Ulf-vom-Mond/heichips26-voltage-controlled-resistor/macros/heichips26_vcr/macros/switched_capacitor/testbenches/xschem/plot_simulations/figures/linearity_vcm_step=0.1_vdm=0.5.pdf

relative deviation from mean resistance in %

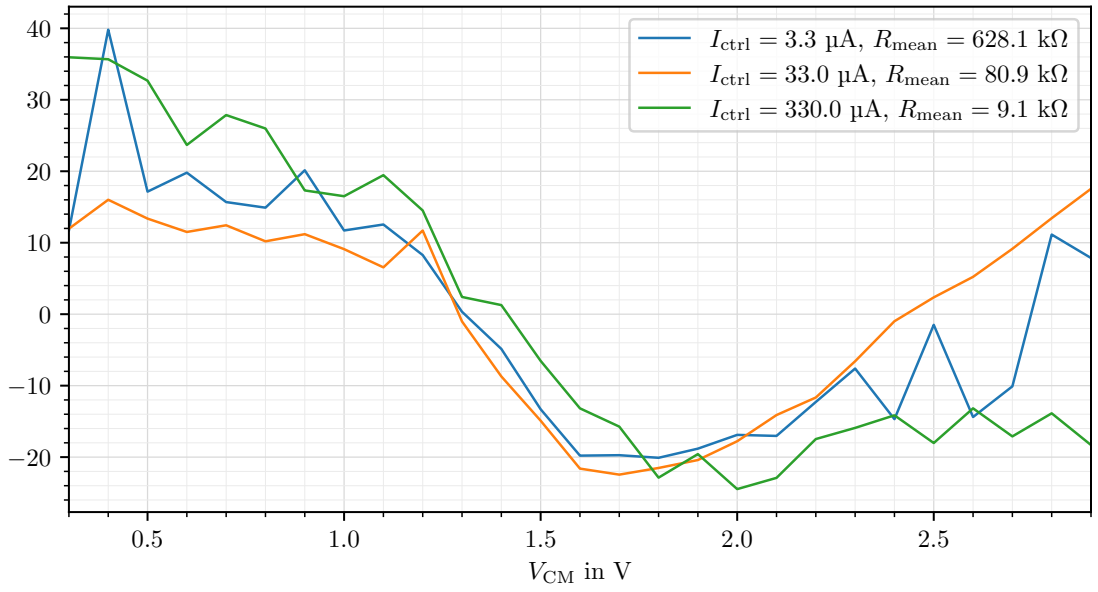
[picture p2: figure]
VCM in V; Ictrl = 3.3; µA, Rmean = 628.1 kΩ; Ictrl = 330.0 µA,; Rmean

Ictrl = 33.0 µA, Rmean = 80.9 kΩ

### Linearity with respect to VCM for VDM = 0.5 V
