Ulf-vom-Mond/heichips26-voltage-controlled-resistor/macros/heichips26_vcr/macros/switched_capacitor/testbenches/xschem/plot_simulations/figures/linearity_ictrl_step=1.1.pdf

### Linearity with respect to Ictrl

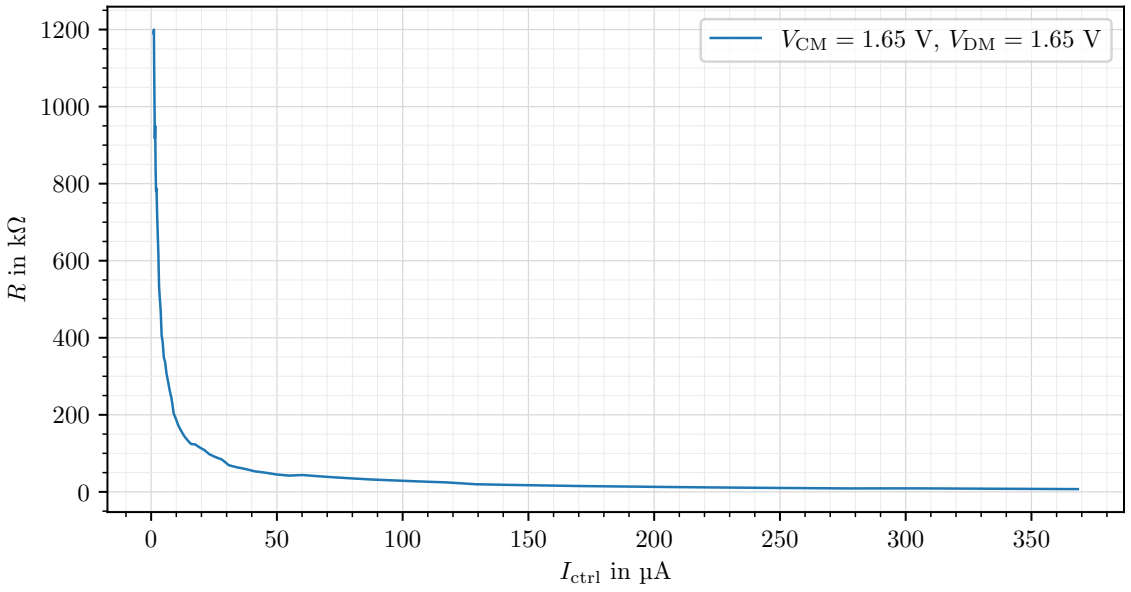
[picture p3: figure]
Ictrl in µA; VCM; V, VDM
