Ulf-vom-Mond/heichips26-voltage-controlled-resistor/macros/heichips26_vcr/macros/switched_capacitor/testbenches/xschem/plot_simulations/figures/linearity_ictrl-1_step=1.1.png

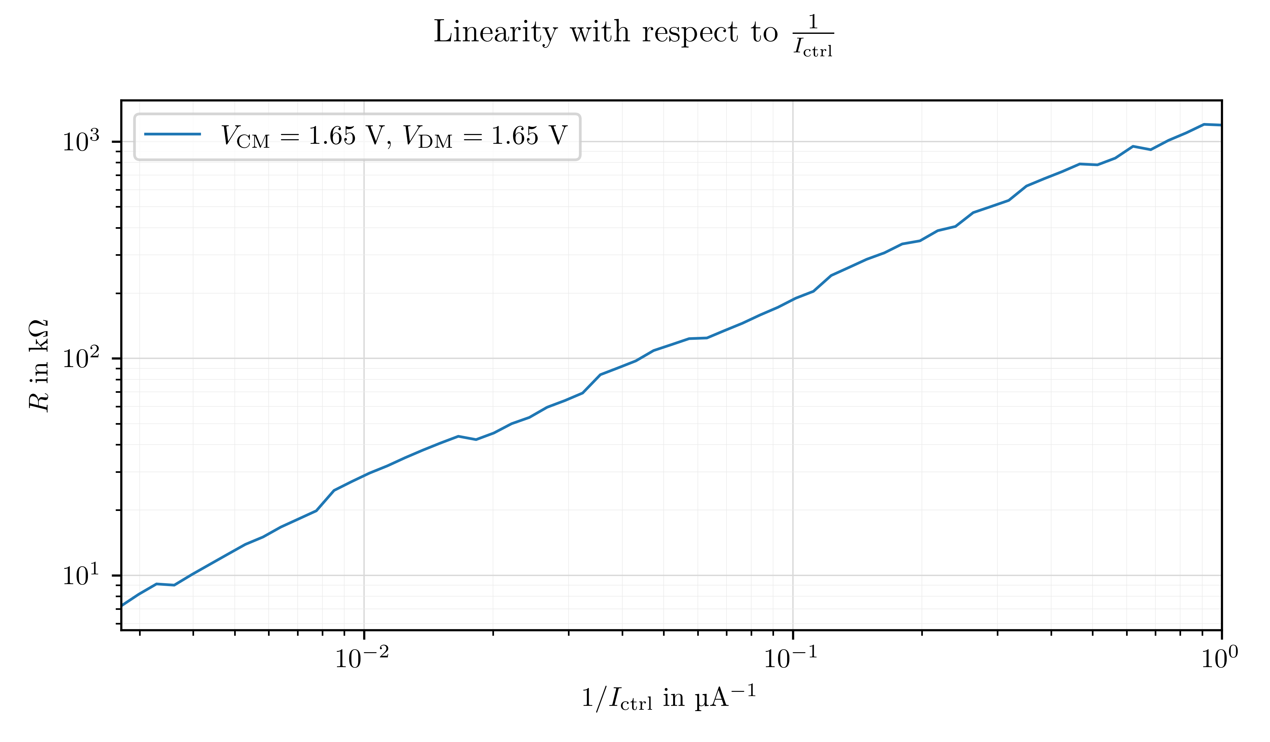
macros/heichips26_vcr/macros/switched_capacitor/testbenches/xschem/plot_simulations/figures/linearity_ictrl-1_step=1.1.png
