Ulf-vom-Mond/heichips26-voltage-controlled-resistor/macros/heichips26_vcr/macros/switched_capacitor/testbenches/xschem/plot_simulations/figures/linearity_ictrl-1.pdf

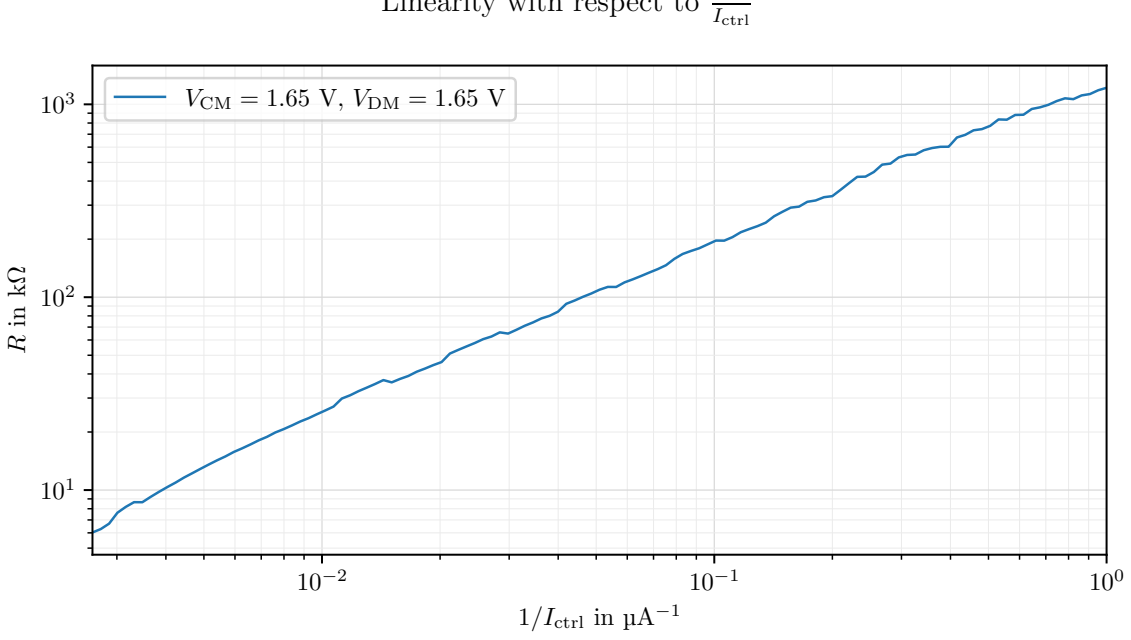
[picture p7: figure]
1/Ictrl in µA−1; VCM; V, VDM = 1.65 V; Ictrl

### Linearity with respect to 1
