Ulf-vom-Mond/heichips26-voltage-controlled-resistor/macros/heichips26_vcr/macros/switched_capacitor/testbenches/xschem/plot_simulations/figures/linearity_vco_vdm_detailed.pdf

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
VDM in V

−40 −200

20

40

relative deviation from median resistance in %
Ictrl | = 0 | .1 | V, | Rmedian | = 11 | .0 kΩ
Ictrl | = 0 | .5 | V, | Rmedian | = 102 | .6 | kΩ
Ictrl | = 3 | .3 | V, | Rmedian | = 1193 | .8 kΩ

### Linearity with respect to

### VDM for

### VCM = 1.65 V
