Ulf-vom-Mond/heichips26-voltage-controlled-resistor/macros/heichips26_vcr/macros/switched_capacitor/testbenches/xschem/plot_simulations/figures/linearity_vdm_detailed.pdf

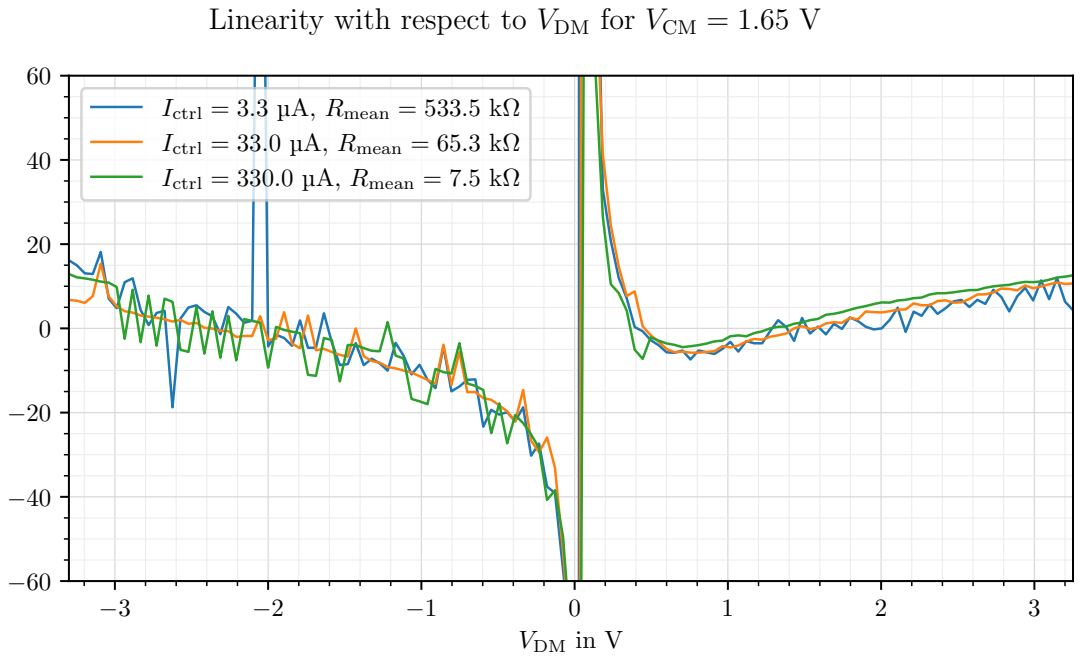
[picture p8: figure]
VDM in V; Ictrl; Rmean; Rmean = 65; Linearity with respect to; VDM for; VCM = 1.65 V

relative deviation from median resistance in %
