Ulf-vom-Mond/heichips26-voltage-controlled-resistor/macros/heichips26_vcr/macros/switched_capacitor/testbenches/xschem/plot_simulations/figures/linearity_vdm_start=0.pdf

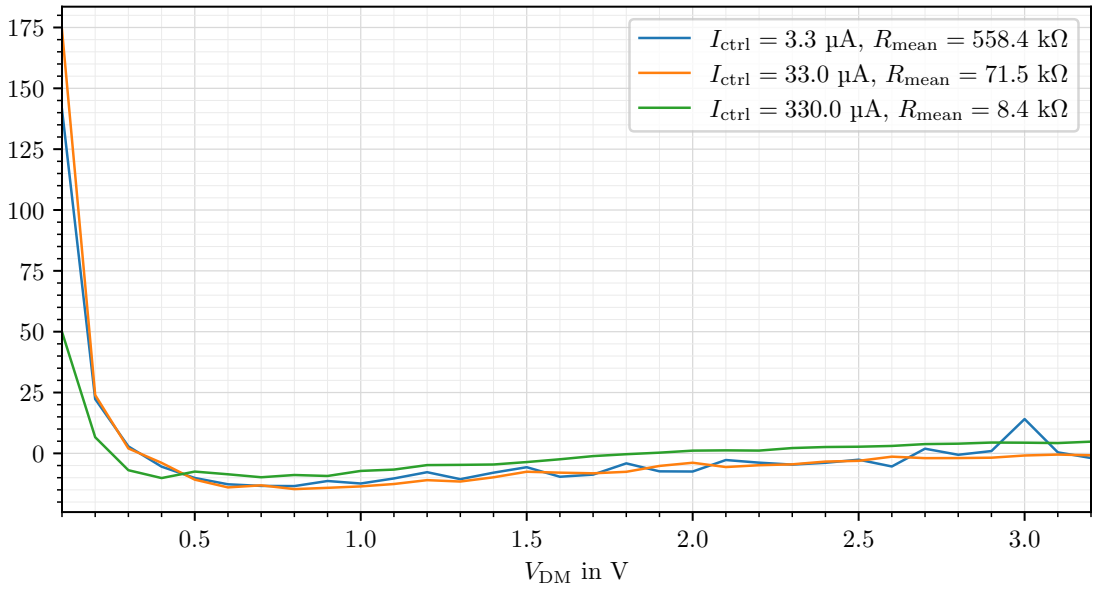
[picture p10: figure]
VDM in V; Ictrl; µA, Rmean = 558.4 kΩ; = 33.0 µA, Rmean; Rmean = 8.4 kΩ

relative deviation from mean resistance in %

### Linearity with respect to VDM for VCM = 1.65 V
