Ulf-vom-Mond/heichips26-voltage-controlled-resistor/macros/heichips26_vcr/macros/switched_capacitor/testbenches/xschem/plot_simulations/figures/inverter_tb_ac_ol.pdf

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

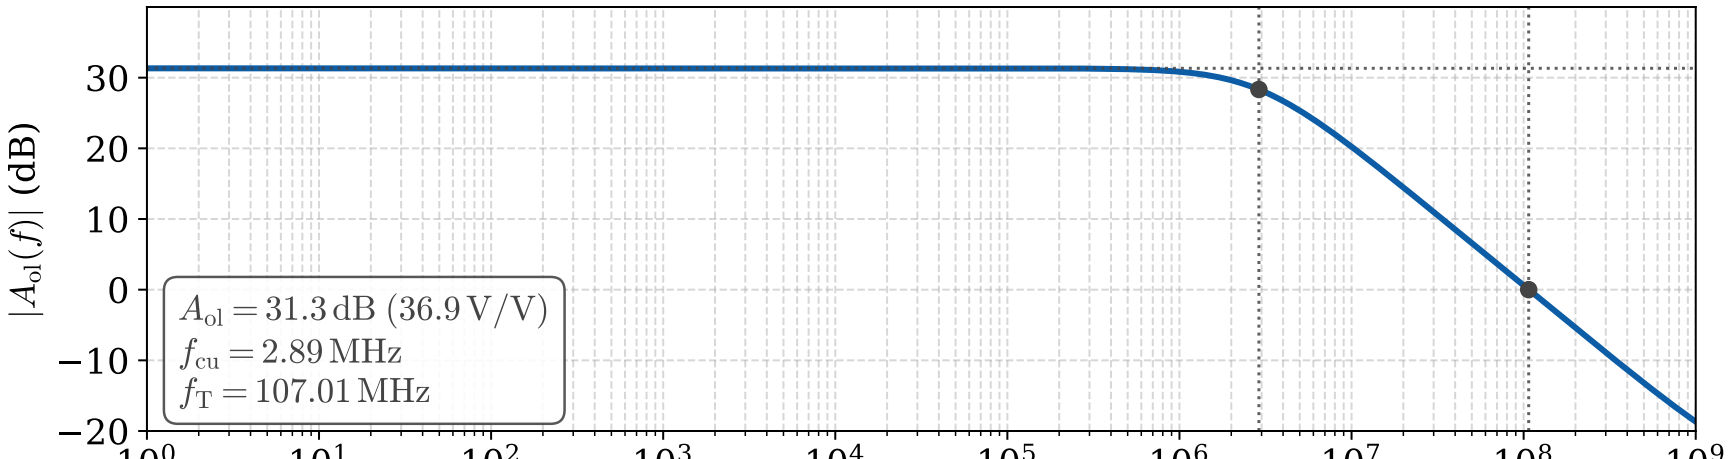
[picture p11: figure]
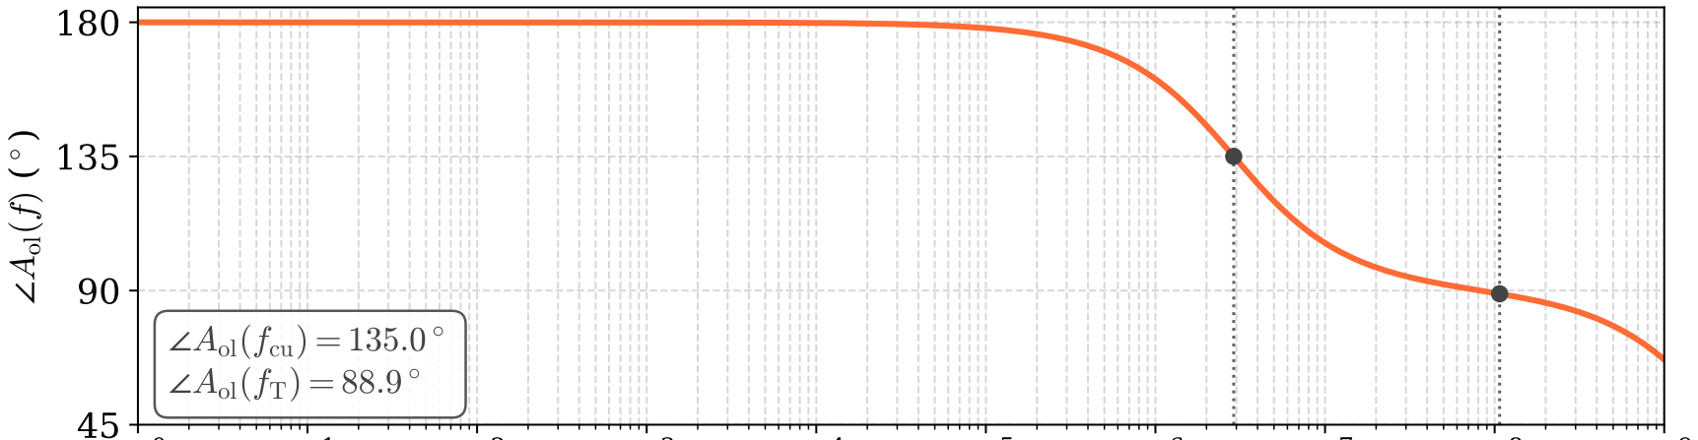
[picture p12: figure]
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
