Ulf-vom-Mond/heichips26-voltage-controlled-resistor/macros/heichips26_vcr/macros/switched_capacitor/testbenches/xschem/plot_simulations/figures/linearity_ictrl.pdf

### Linearity with respect to Ictrl

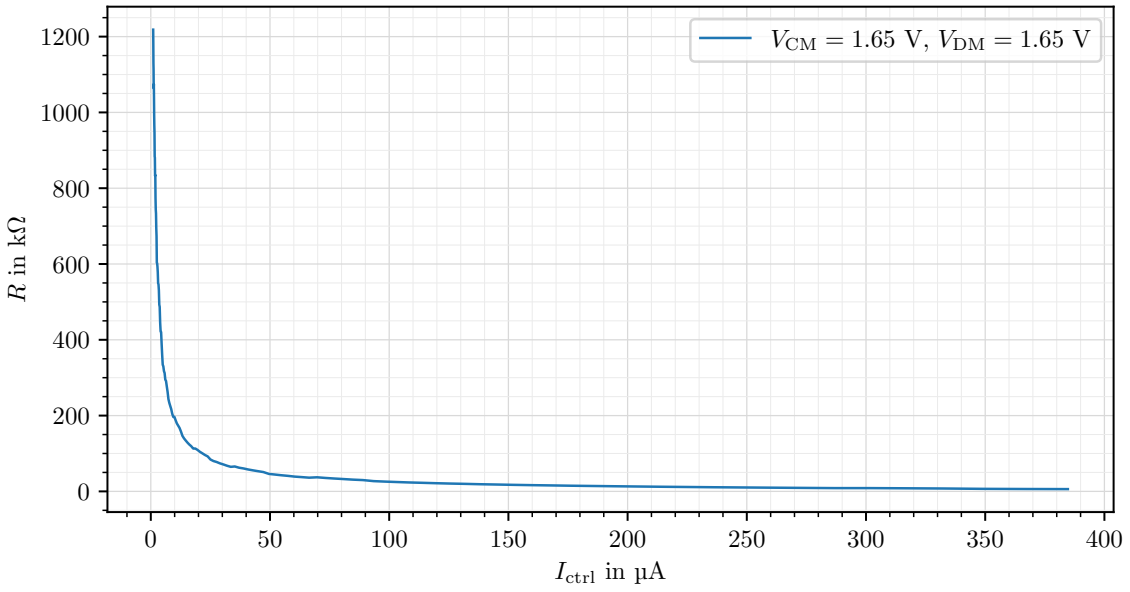
[picture p13: figure]
Ictrl in µA; VCM; VDM
