Ulf-vom-Mond/heichips26-voltage-controlled-resistor/macros/heichips26_vcr/testbenches/xschem/plot_simulations/figures/heichips26_analog_project_tb_tran.csv

time_ms | uio_in_0 | analog_0 | analog_1 | analog_2
0.000000000000000000e+00 | 0.000000000000000000e+00 | 7.500000000000000000e-01 | 5.371804900000000105e-01 | 1.499998240000000038e+00
1.000000000000000087e-07 | 1.499999999999999944e-02 | 7.500000060000000524e-01 | 5.371804900000000105e-01 | 1.500930510000000107e+00
2.000000000000000174e-07 | 2.999999999999999889e-02 | 7.500000129999999654e-01 | 5.371804890000000388e-01 | 1.501783129999999966e+00
4.000000000000000348e-07 | 5.999999999999999778e-02 | 7.500000249999999591e-01 | 5.371804869999999843e-01 | 1.503318050000000072e+00
8.000000000000000697e-07 | 1.199999999999999956e-01 | 7.500000500000000292e-01 | 5.371804780000000168e-01 | 1.505754159999999953e+00
1.600000000000000139e-06 | 2.399999999999999911e-01 | 7.500001010000000301e-01 | 5.371804399999999813e-01 | 1.508771639999999969e+00
2.157522970000000198e-06 | 3.236284449999999868e-01 | 7.500001360000000394e-01 | 5.371803979999999479e-01 | 1.509247840000000007e+00
2.785727209999999671e-06 | 4.178590810000000211e-01 | 7.500001750000000467e-01 | 5.371803360000000360e-01 | 1.507161699999999938e+00
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
