Ulf-vom-Mond/heichips26-voltage-controlled-resistor/macros/heichips26_vcr/macros/switched_capacitor/verification/cace/scripts/inverter_tb_ac.csv

Adc_ol_dB_arr | fcu_arr
2.405539999999999878e+01 | 6.704690000000000000e+06
1.506770000000000032e+01 | 1.600880000000000000e+07
2.489160000000000039e+01 | 6.194410000000000000e+06
2.377299999999999969e+01 | 6.722840000000000000e+06
2.597490000000000165e+01 | 5.180040000000000000e+06
1.481630000000000003e+01 | 1.659160000000000000e+07
1.343140000000000001e+01 | 1.809050000000000000e+07
1.512870000000000026e+01 | 1.499380000000000000e+07
9.545130000000000337e+00 | 2.905970000000000000e+07
3.096499999999999986e+01 | 2.854580000000000000e+06
9.753949999999999676e+00 | 2.789630000000000000e+07
2.980600000000000094e+01 | 3.415400000000000000e+06
1.348509999999999920e+01 | 2.118120000000000000e+07
3.199399999999999977e+01 | 2.592250000000000000e+06
2.780999999999999872e+01 | 4.148880000000000000e+06
3.094460000000000122e+01 | 3.008110000000000000e+06
3.020319999999999894e+01 | 3.234940000000000000e+06
1.413889999999999958e+01 | 1.820030000000000000e+07
8.673180000000000334e+00 | 2.784930000000000000e+07
1.210999999999999943e+01 | 2.263300000000000000e+07
7.307129999999999903e+00 | 3.552400000000000000e+07
2.046969999999999956e+01 | 9.596920000000000000e+06
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
