Ulf-vom-Mond/heichips26-voltage-controlled-resistor/macros/heichips26_vcr/macros/switched_capacitor/testbenches/xschem/plot_simulations/figures/linearity_vcm.pdf

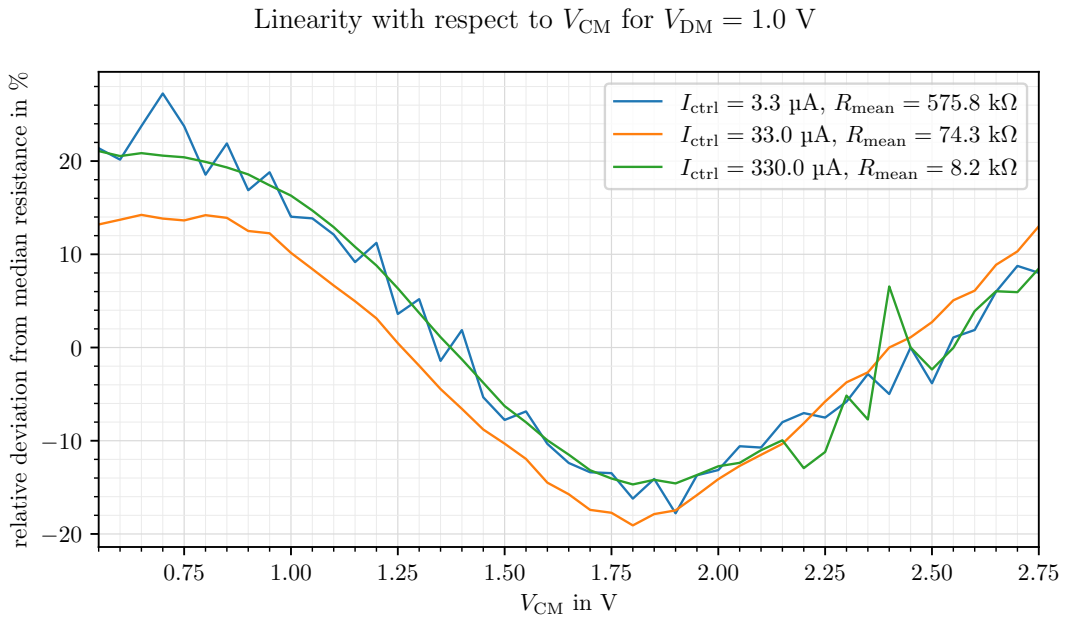
[picture p23: page 1]
VCM in V; Ictrl; Rmean = 8.2 kΩ

Linearity with respect to VCM for VDM = 1.0 V

relative deviation from median resistance in %

Ictrl | = 3.3 | µA, | Rmean = 575.8 kΩ
Ictrl | = 33.0 µA, | | | Rmean | = 74.3 kΩ
