Ulf-vom-Mond/heichips26-voltage-controlled-resistor/macros/heichips26_vcr/macros/switched_capacitor/testbenches/xschem/plot_simulations/figures/linearity_vco_vcm.pdf

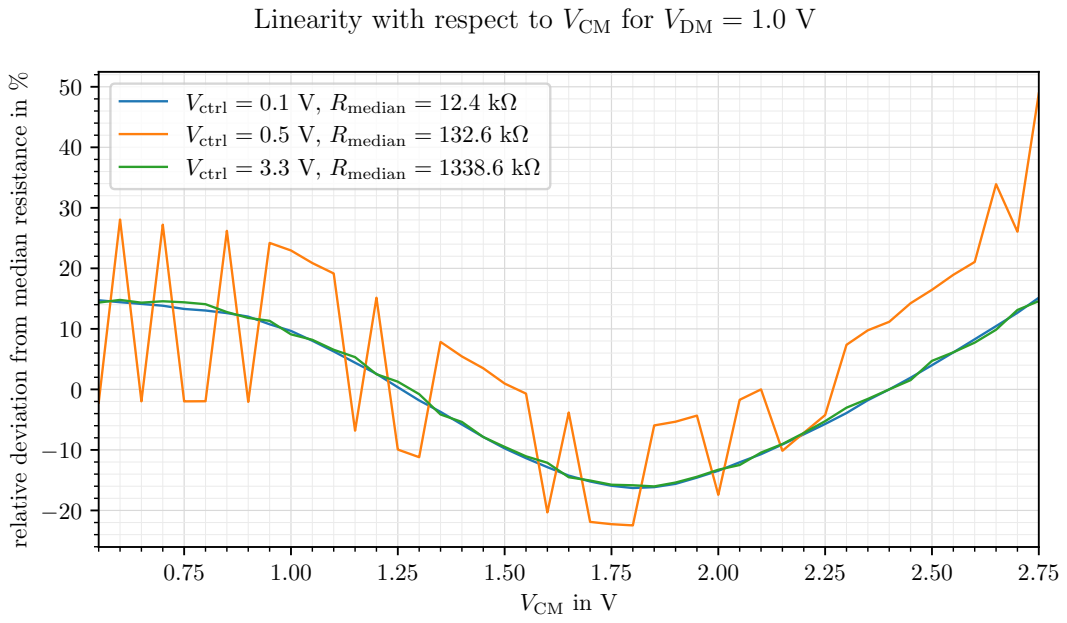
[picture p24: page 1]
VCM in V; Vctrl; Rmedian = 12; Rmedian = 132; Rmedian = 1338; VCM for; VDM = 1.0 V

Linearity with respect to

relative deviation from median resistance in %
