Ulf-vom-Mond/heichips26-voltage-controlled-resistor/macros/heichips26_vcr/macros/switched_capacitor/testbenches/xschem/plot_simulations/figures/linearity_vco_vdm.pdf

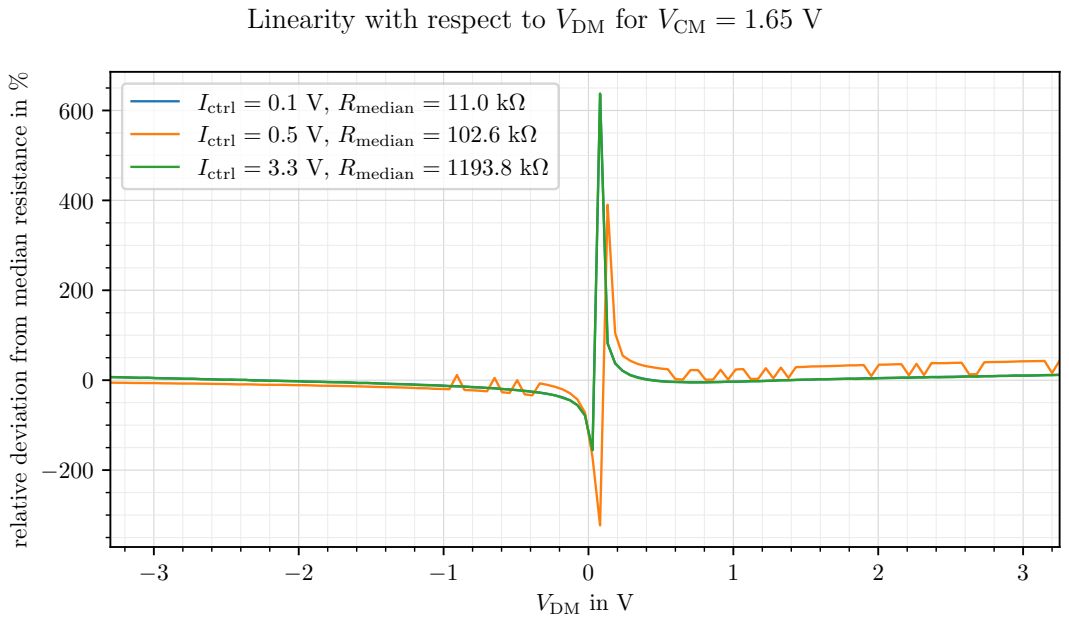
[picture p25: page 1]
VDM in V; Ictrl; Rmedian; VDM for; VCM = 1.65 V

Linearity with respect to

relative deviation from median resistance in %

Ictrl | = 0 | .5 | V, | Rmedian | = 102 | .6 | kΩ

Ictrl | = 3 | .3 | V, | Rmedian | = 1193 | .8 kΩ
