Ulf-vom-Mond/heichips26-voltage-controlled-resistor/macros/heichips26_vcr/macros/switched_capacitor/testbenches/xschem/plot_simulations/figures/linearity_vdm.pdf

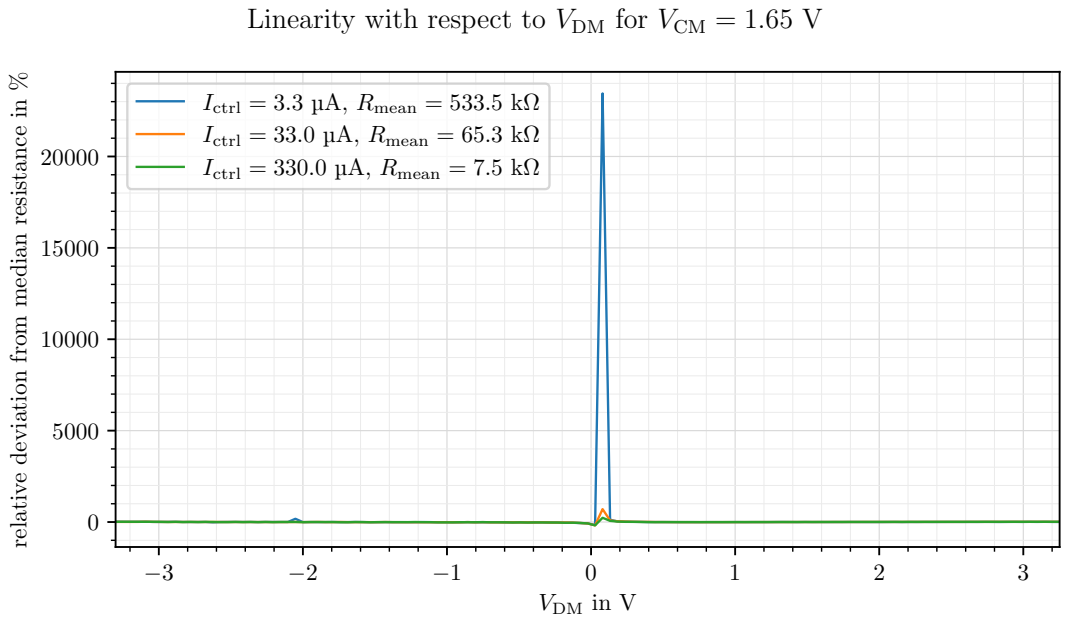
[picture p26: page 1]
VDM in V; VDM for; VCM = 1.65 V

Linearity with respect to

relative deviation from median resistance in %

Ictrl | = 3 | . 3 | µA, | Rmean | | = 533 | | .5 | kΩ
Ictrl | = 33 | . | 0 µA, | | Rmean = 65 | | | .3 | kΩ
Ictrl | = 330 | | . 0 | µA, | Rmean | | = 7 | .5 | kΩ
