Ulf-vom-Mond/heichips26-voltage-controlled-resistor/macros/heichips26_vcr/macros/switched_capacitor/testbenches/xschem/plot_simulations/figures/inverter_tb_dc_vout.pdf

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

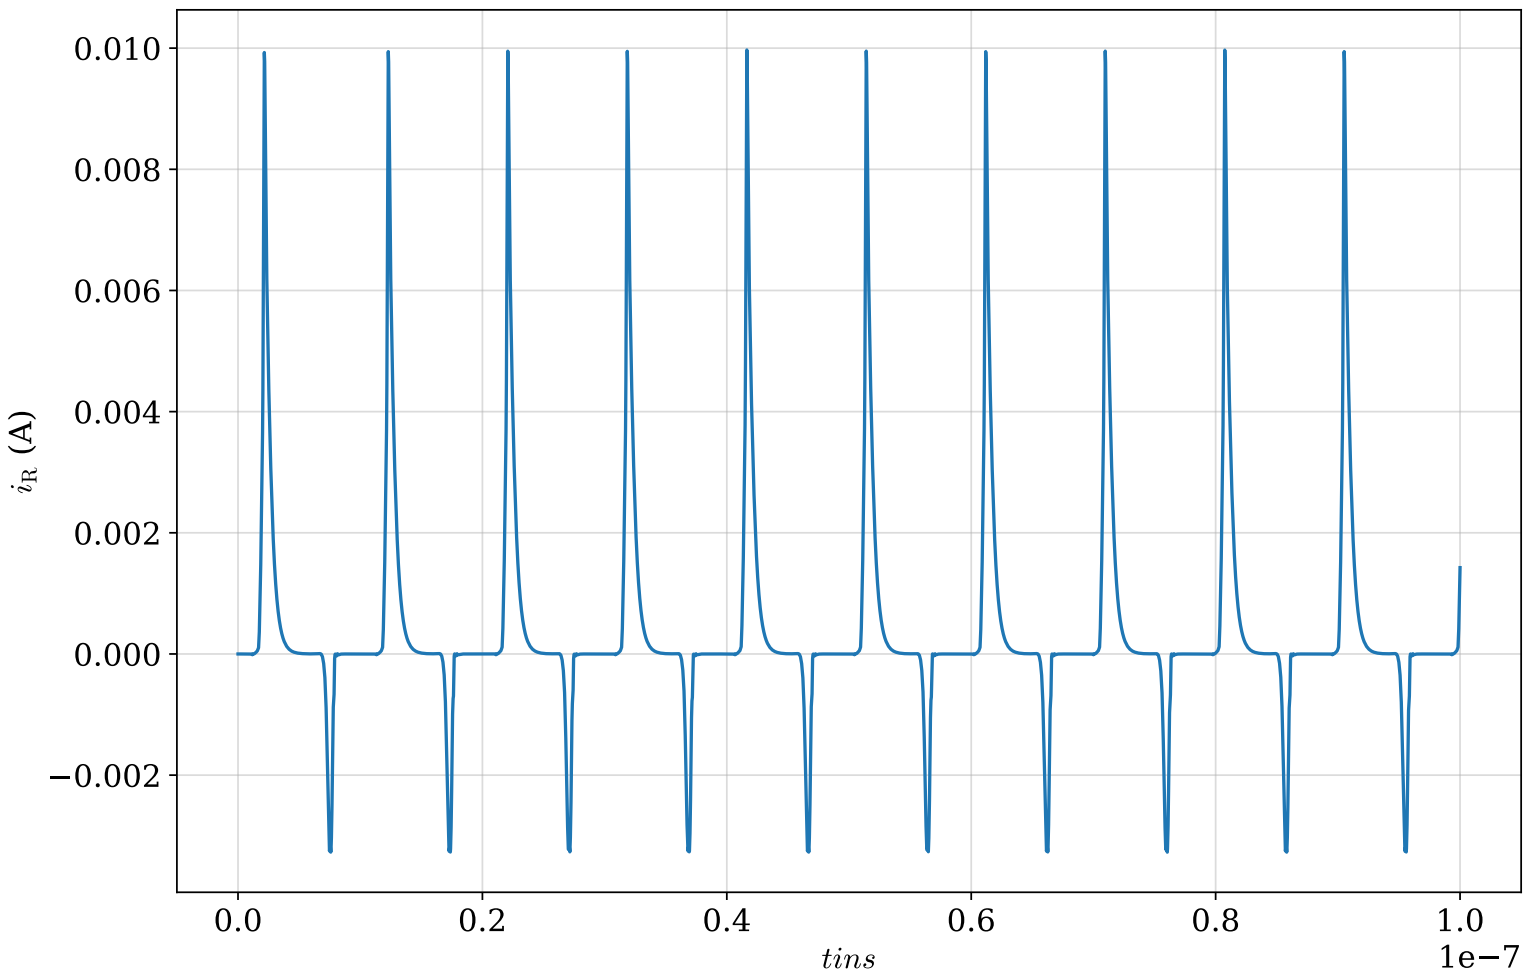
[picture p27: page 1]
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
