Ulf-vom-Mond/heichips26-voltage-controlled-resistor/macros/heichips26_vcr/macros/switched_capacitor/testbenches/xschem/plot_simulations/figures/tb_switched_cap_tran.pdf

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

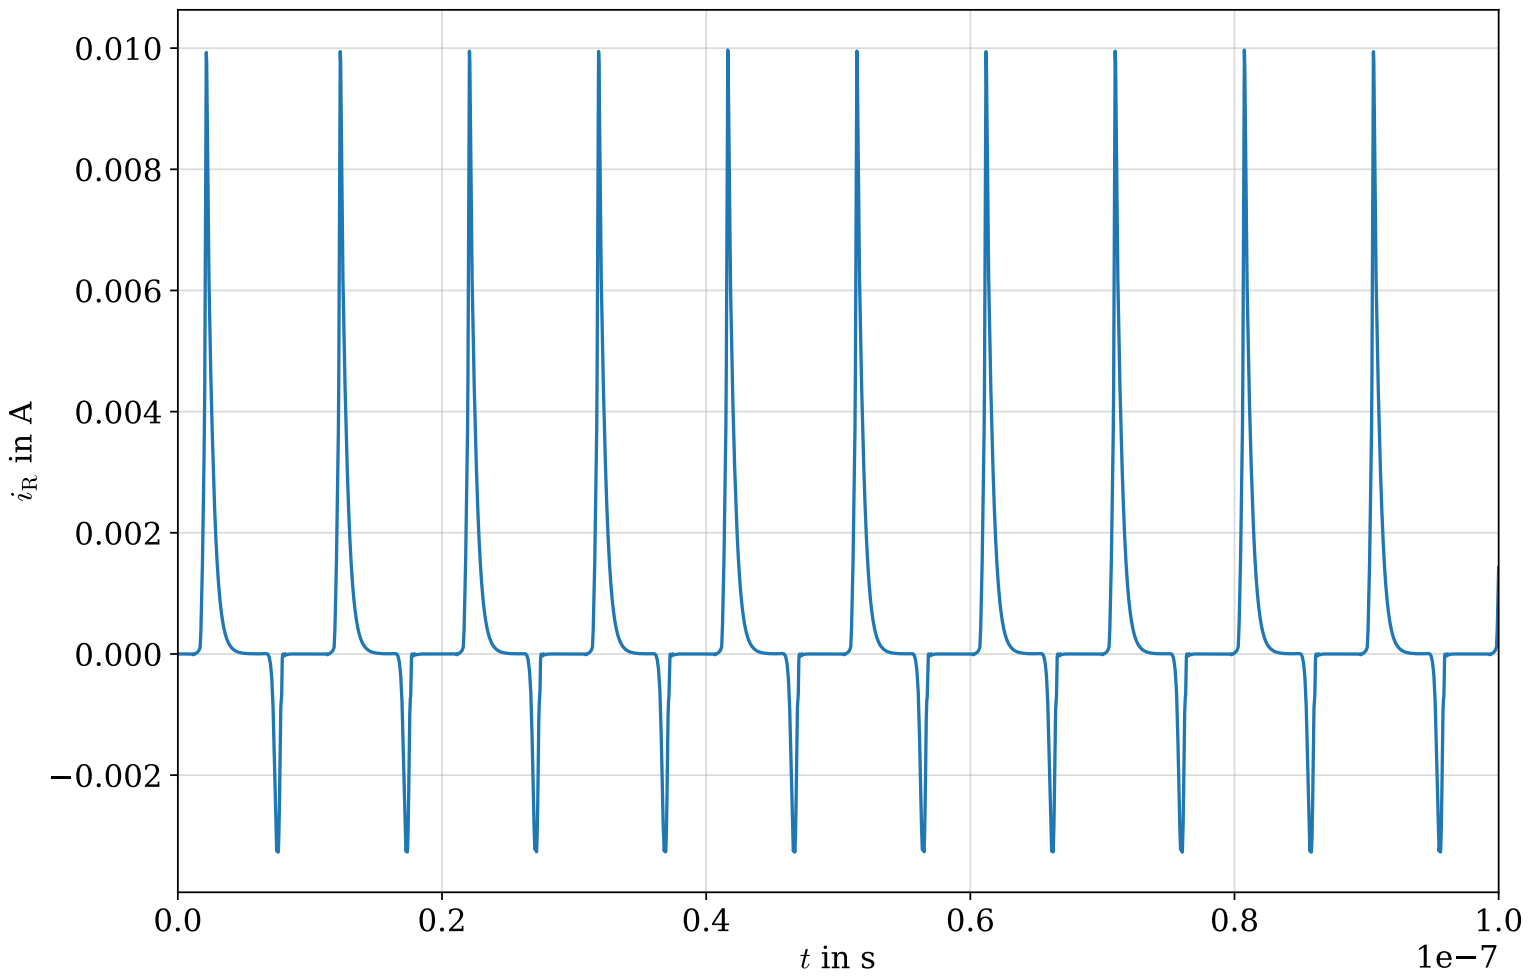
[picture p28: page 1]
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
