Ulf-vom-Mond/heichips26-voltage-controlled-resistor/macros/heichips26_vcr/macros/switched_capacitor/final/render/xschem_plot.pdf

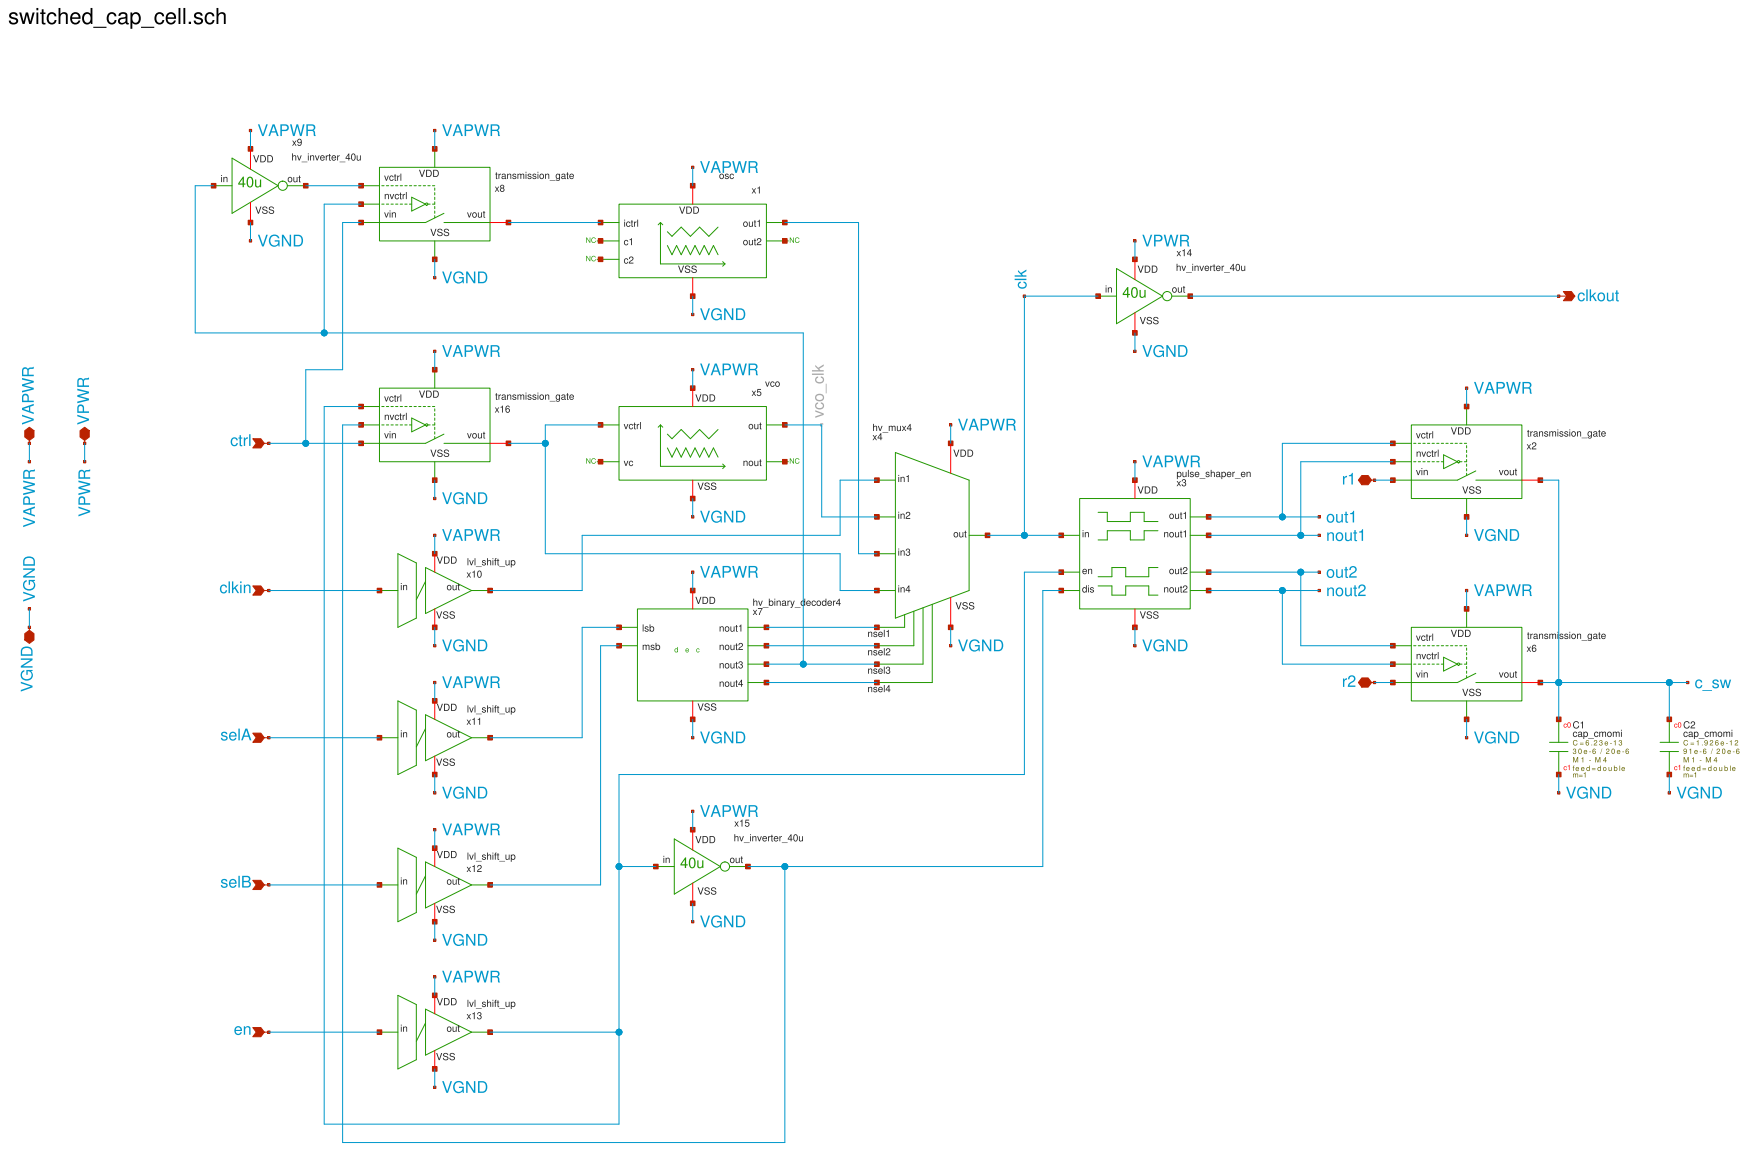
[picture p29: page 1]

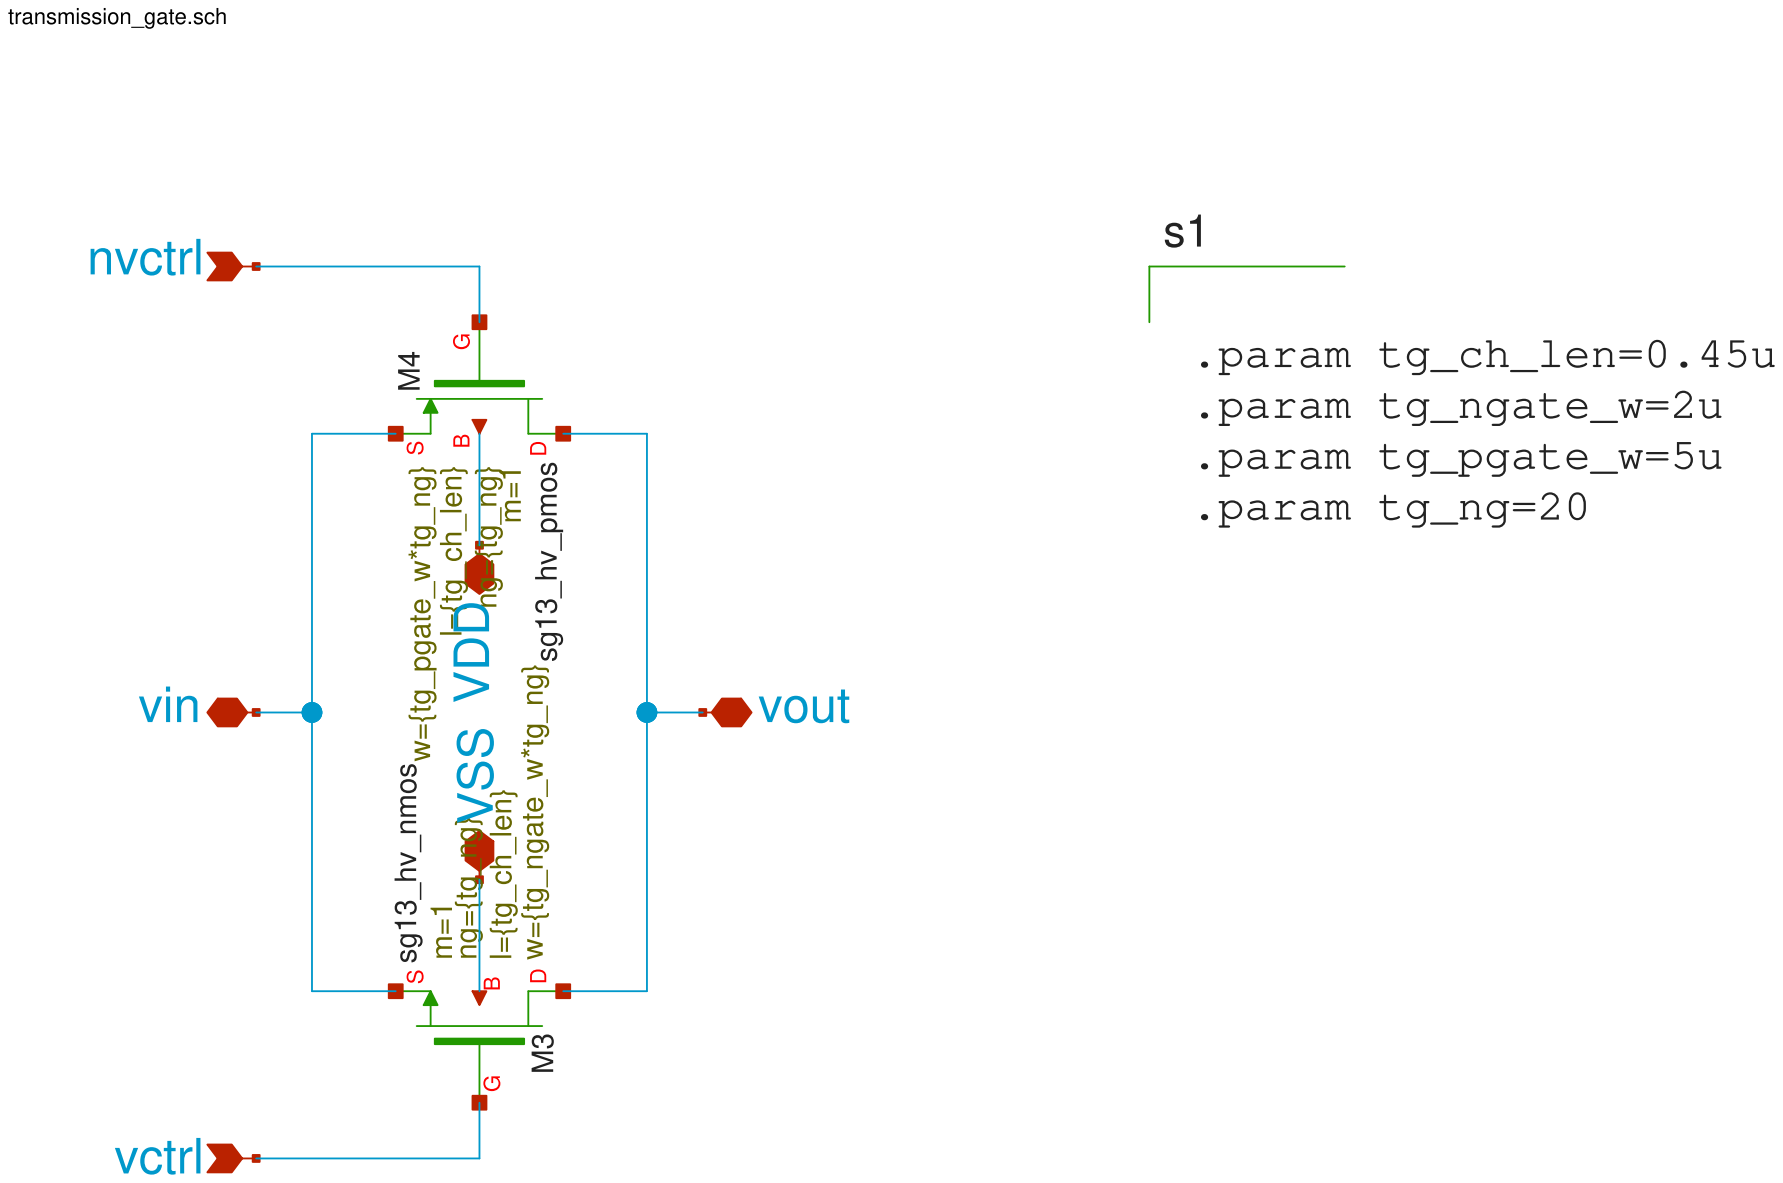
[picture p30: page 2]

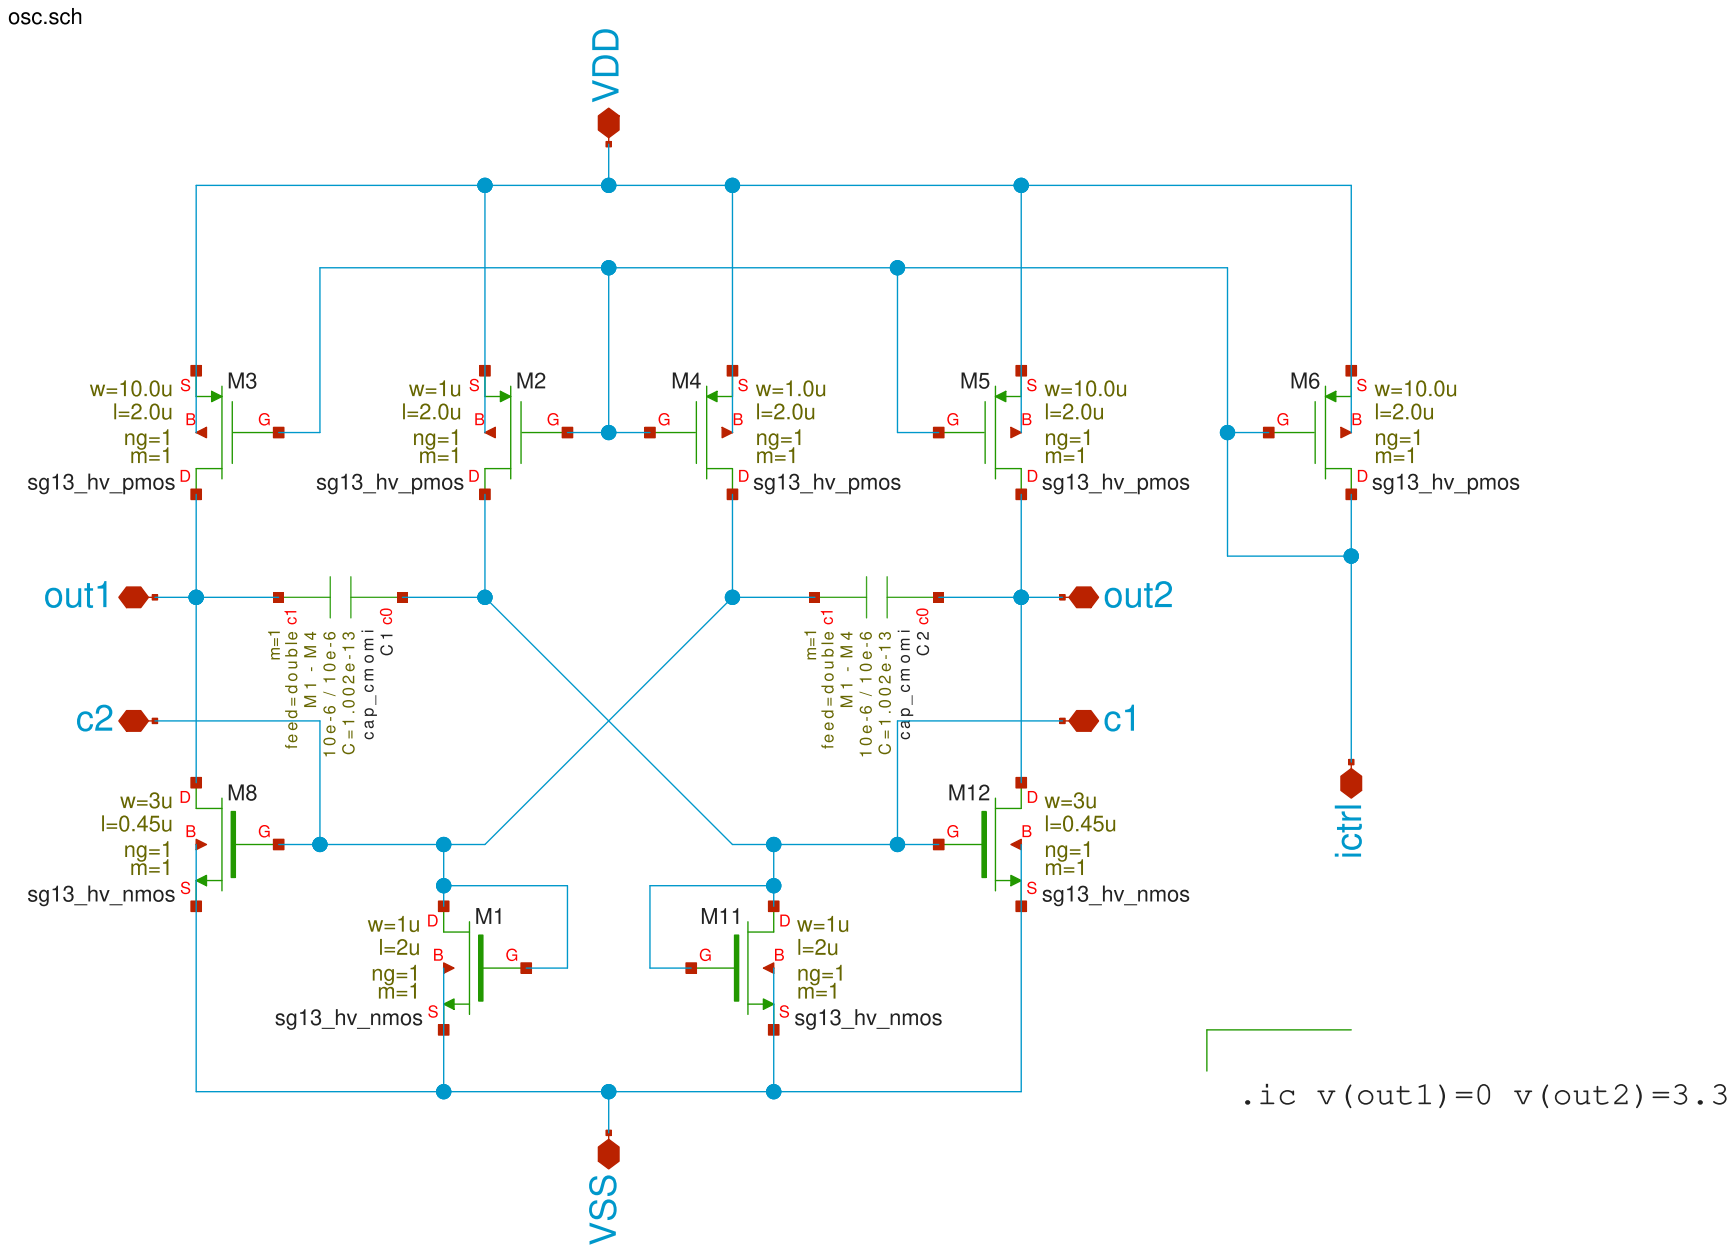
[picture p31: page 3]

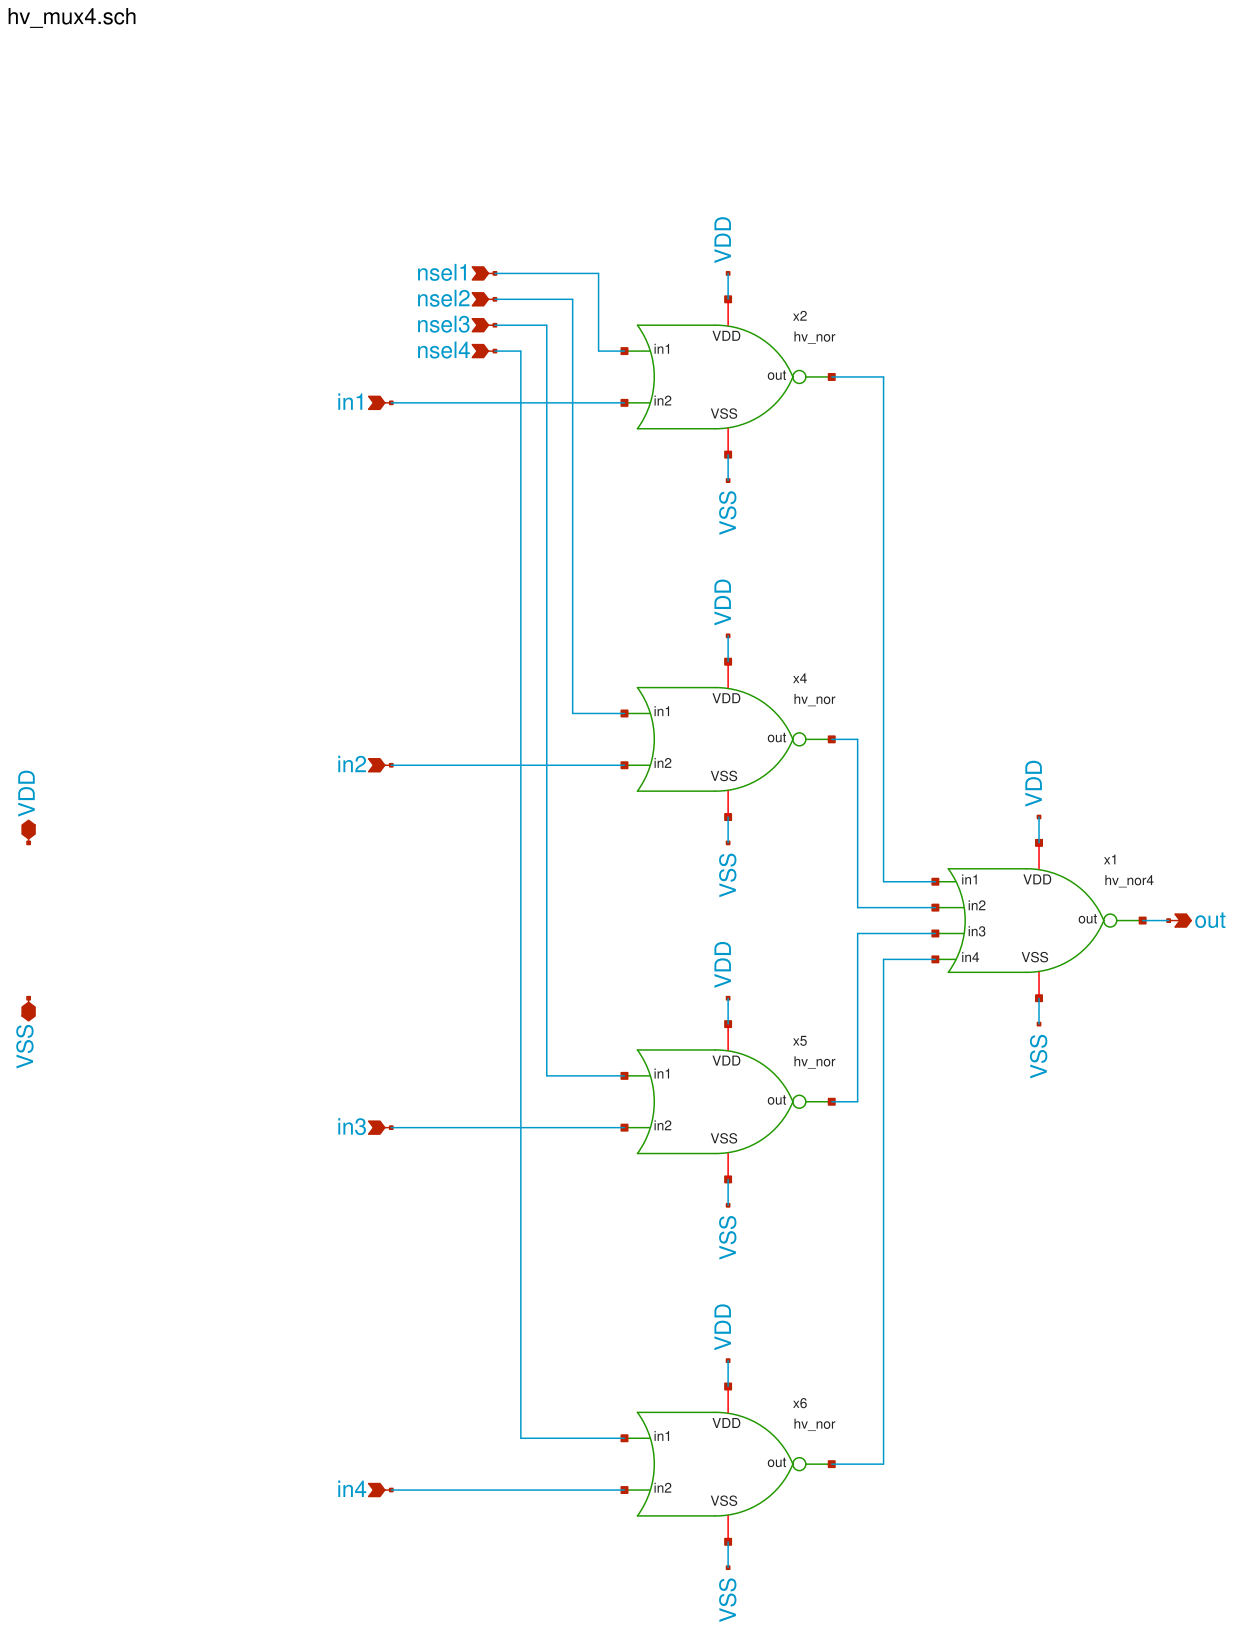
[picture p32: page 4]

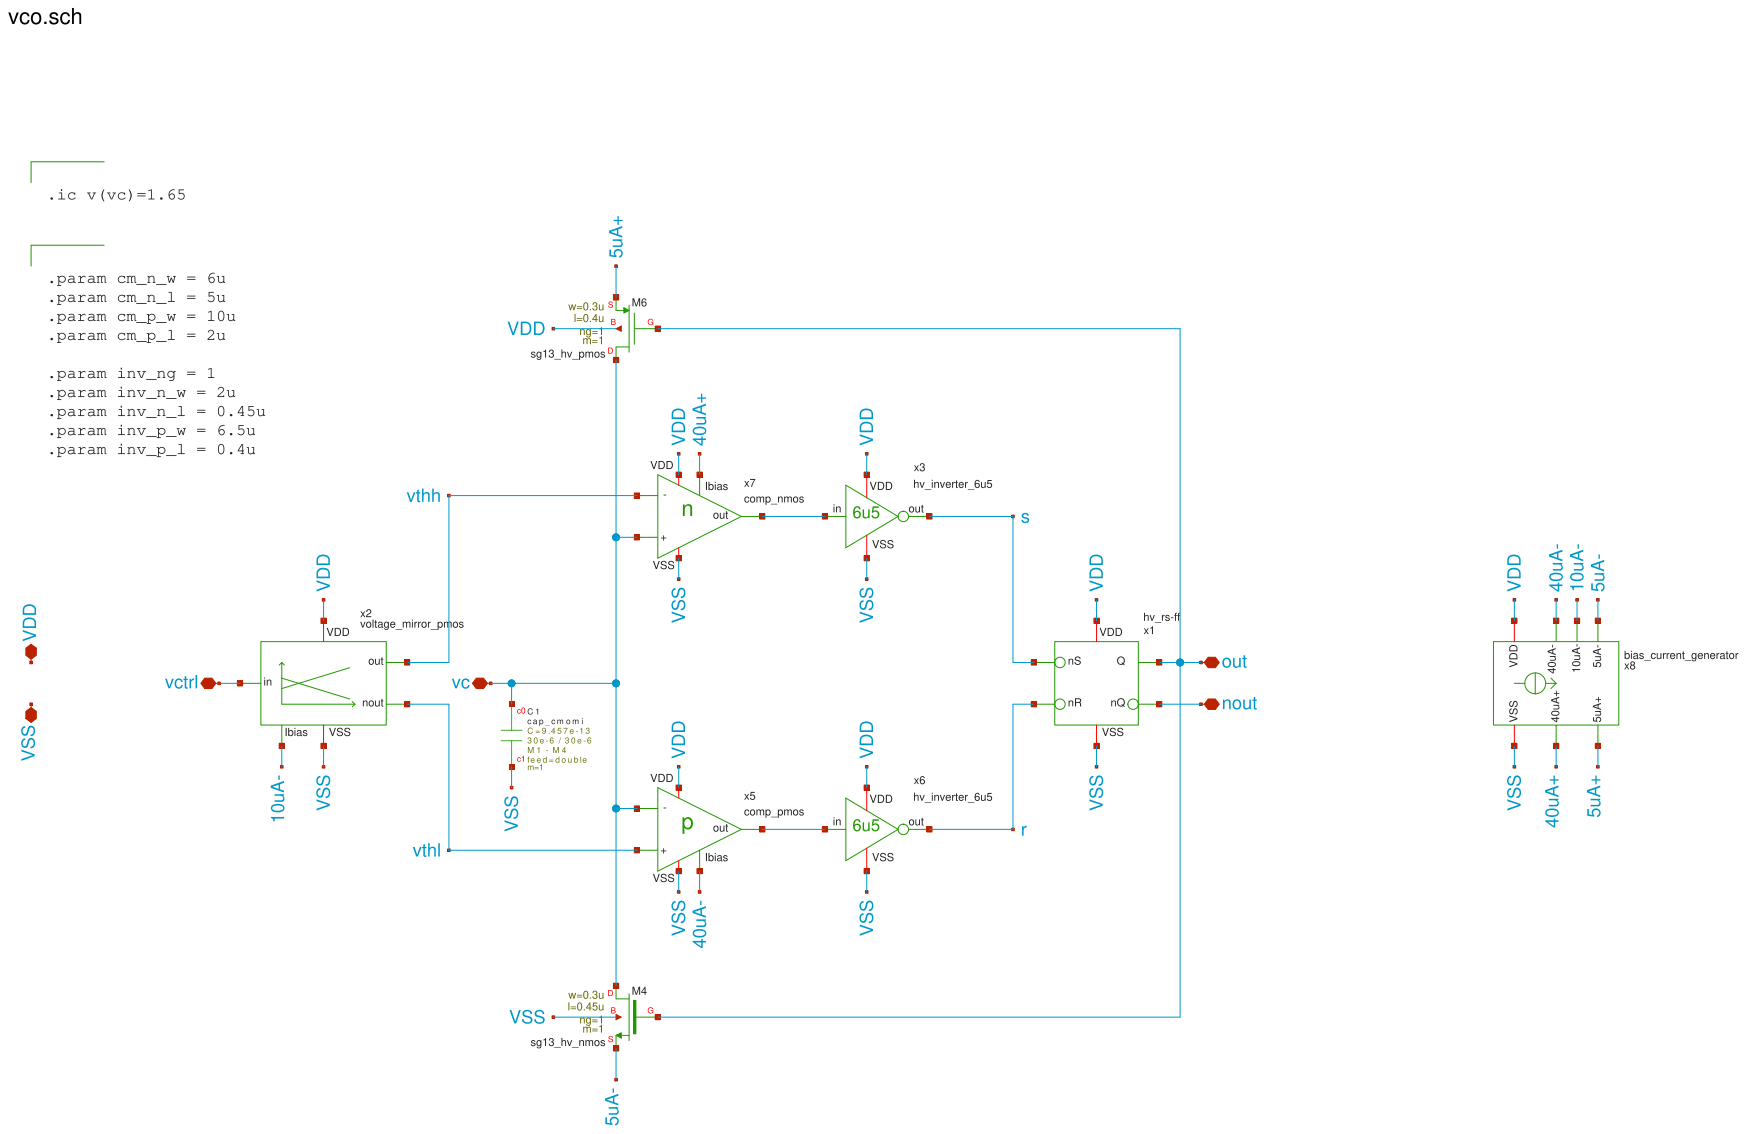
[picture p33: page 5]

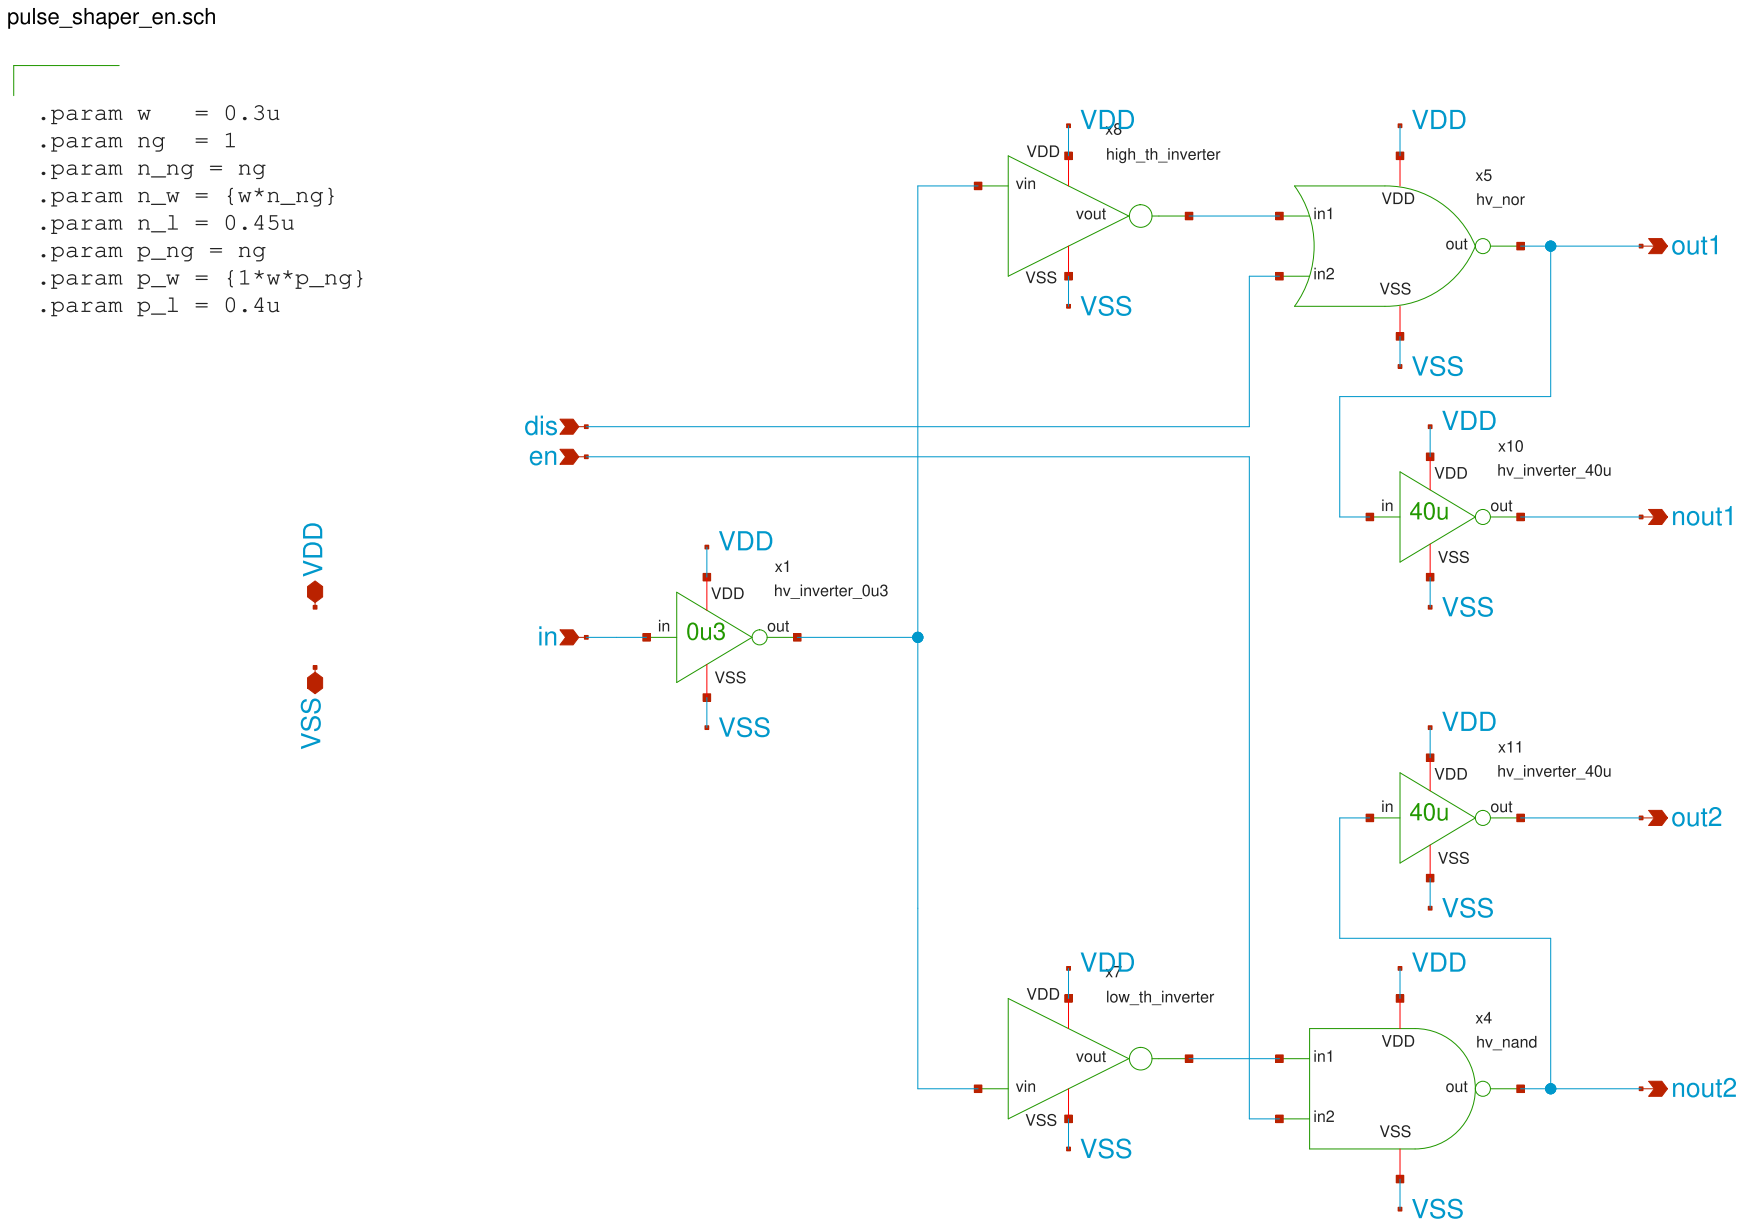
[picture p34: page 6]

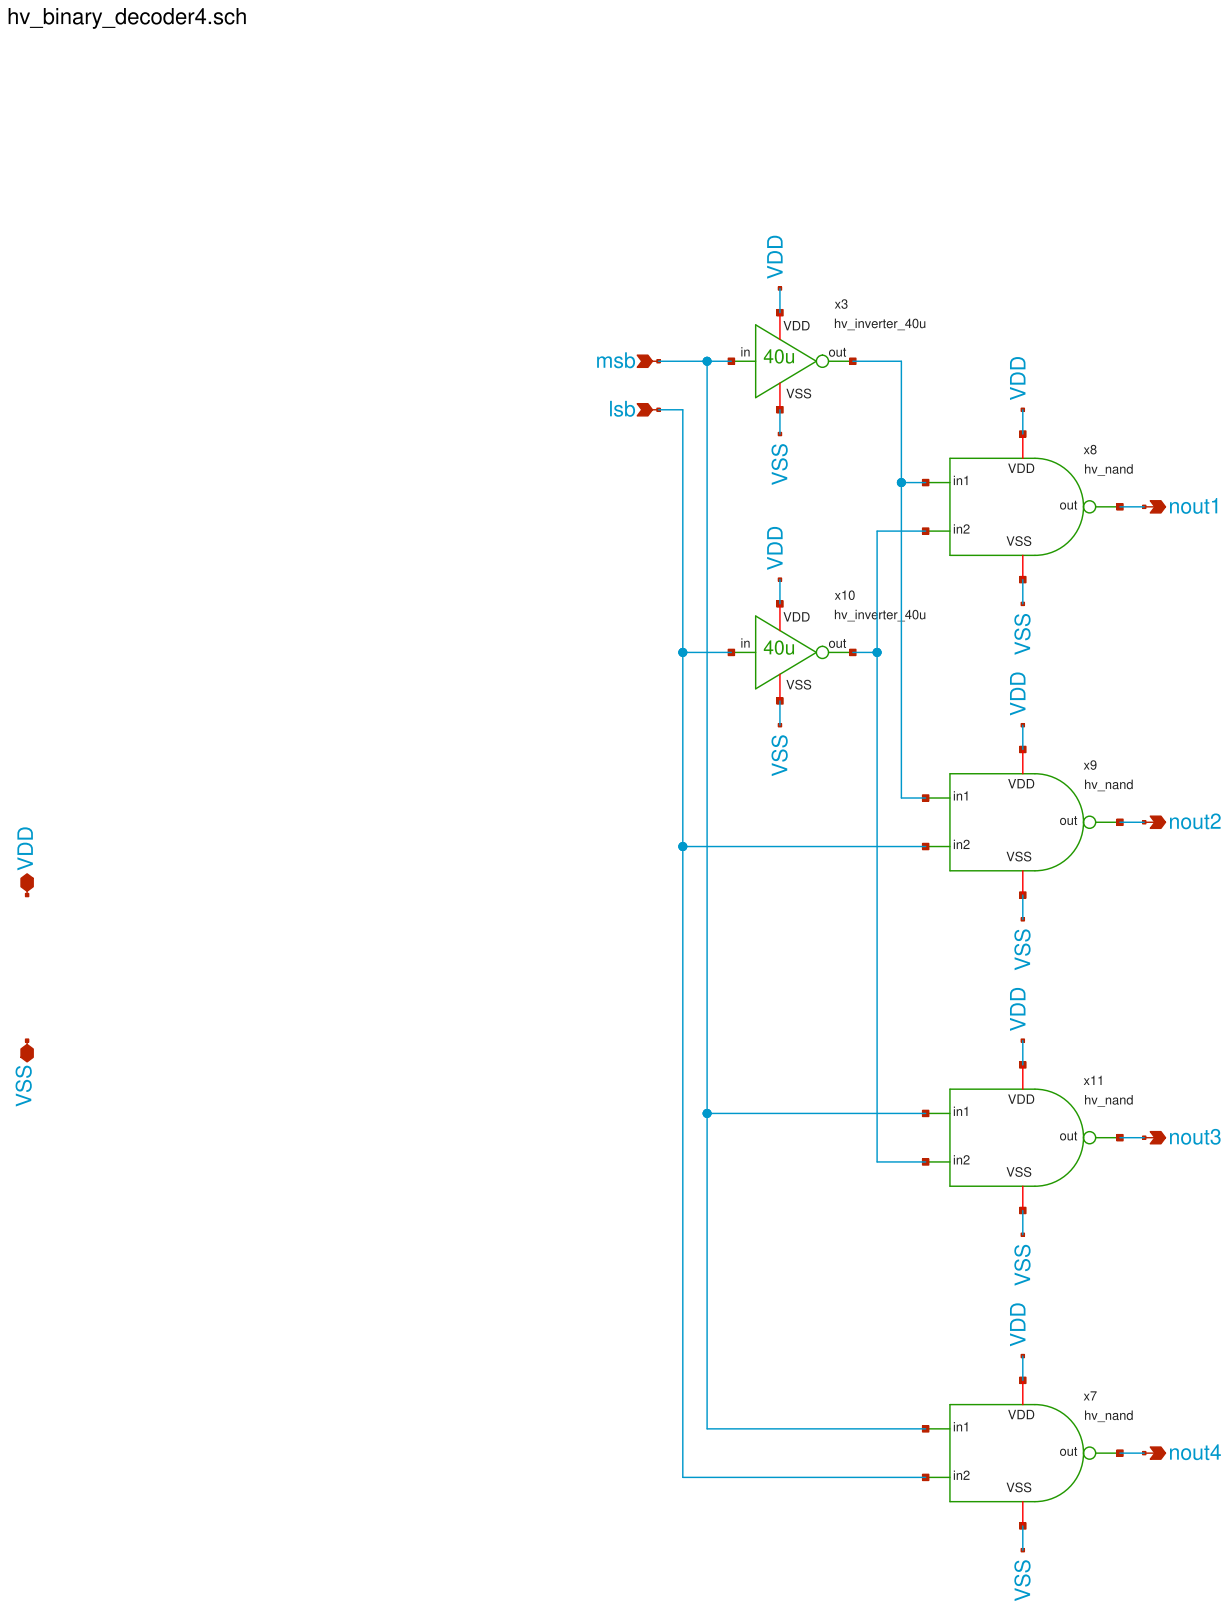
[picture p35: page 7]

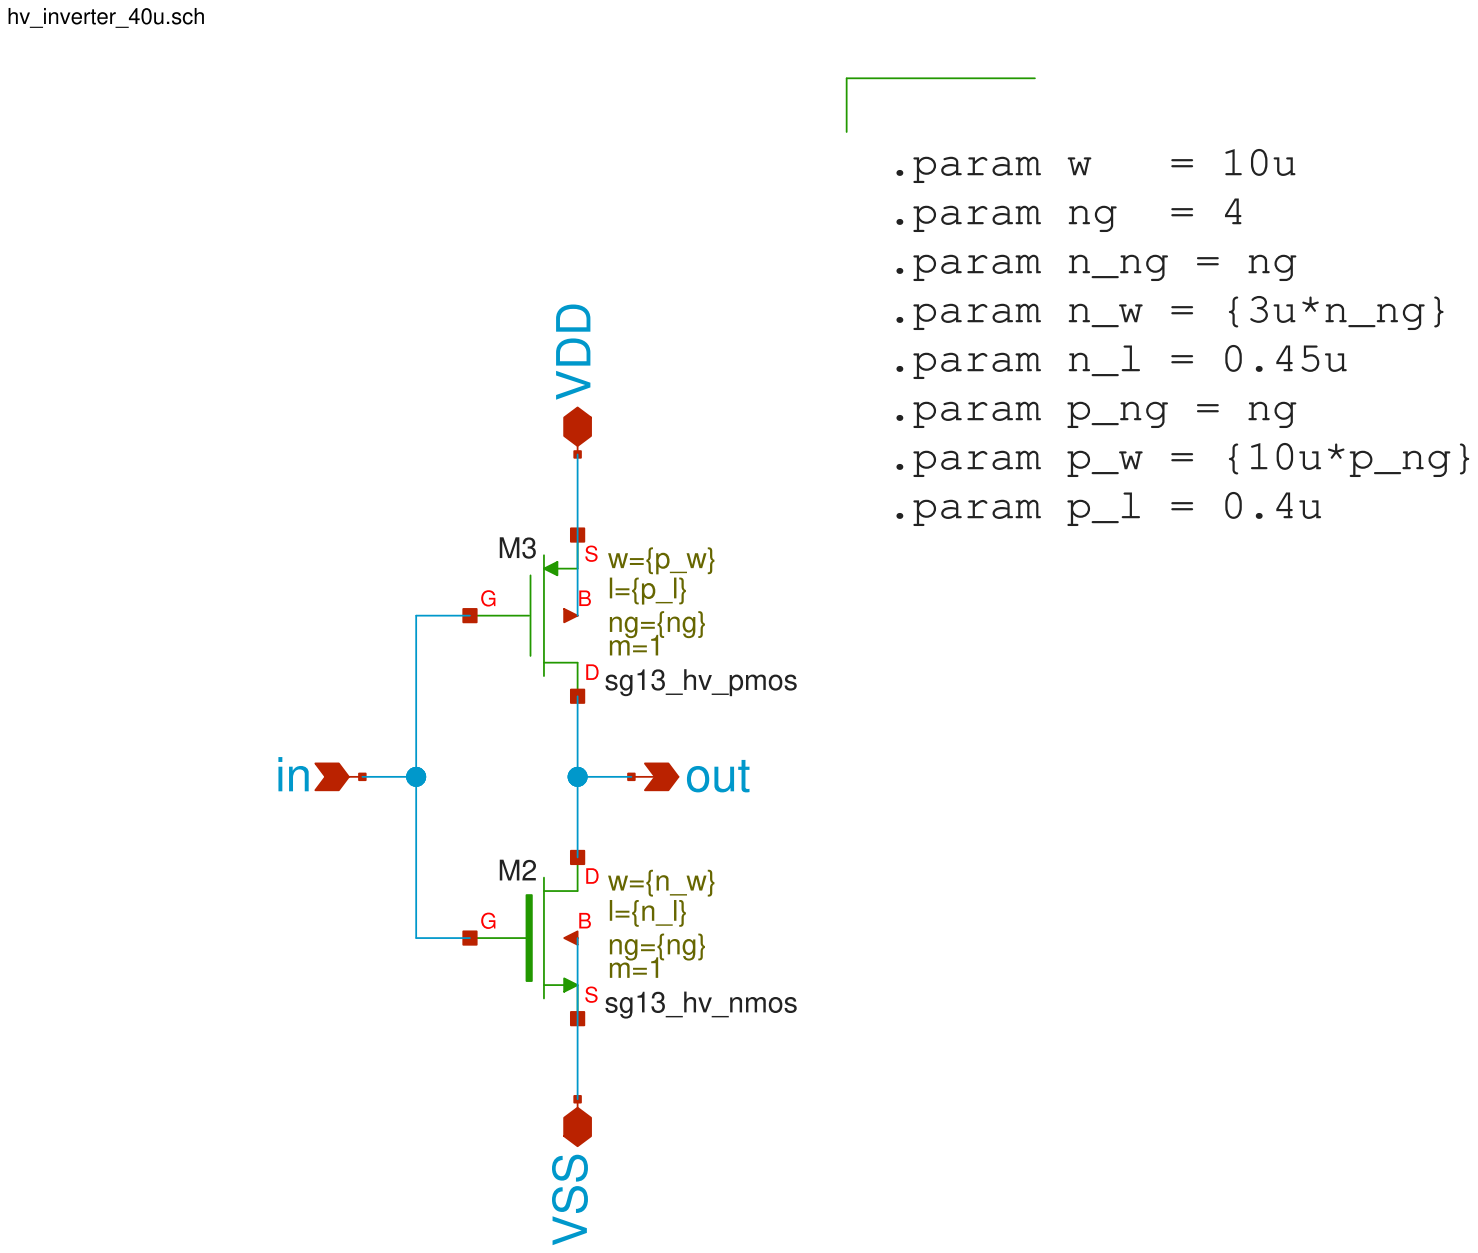
[picture p36: page 8]

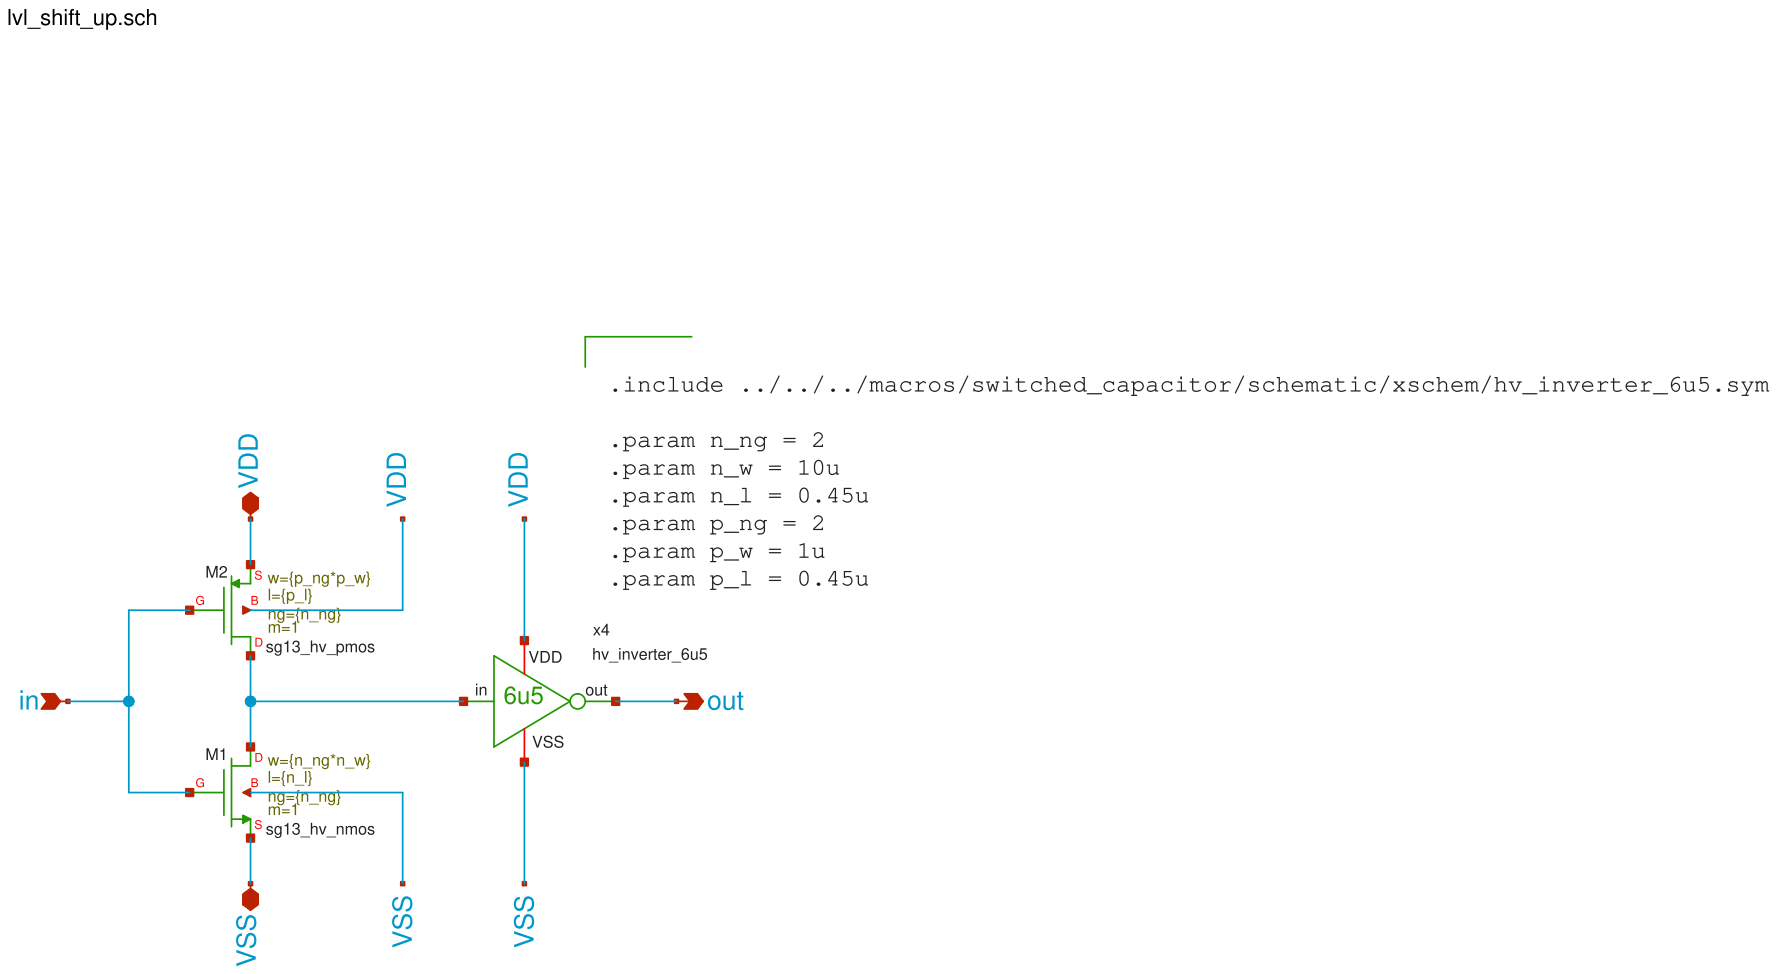
[picture p37: page 9]

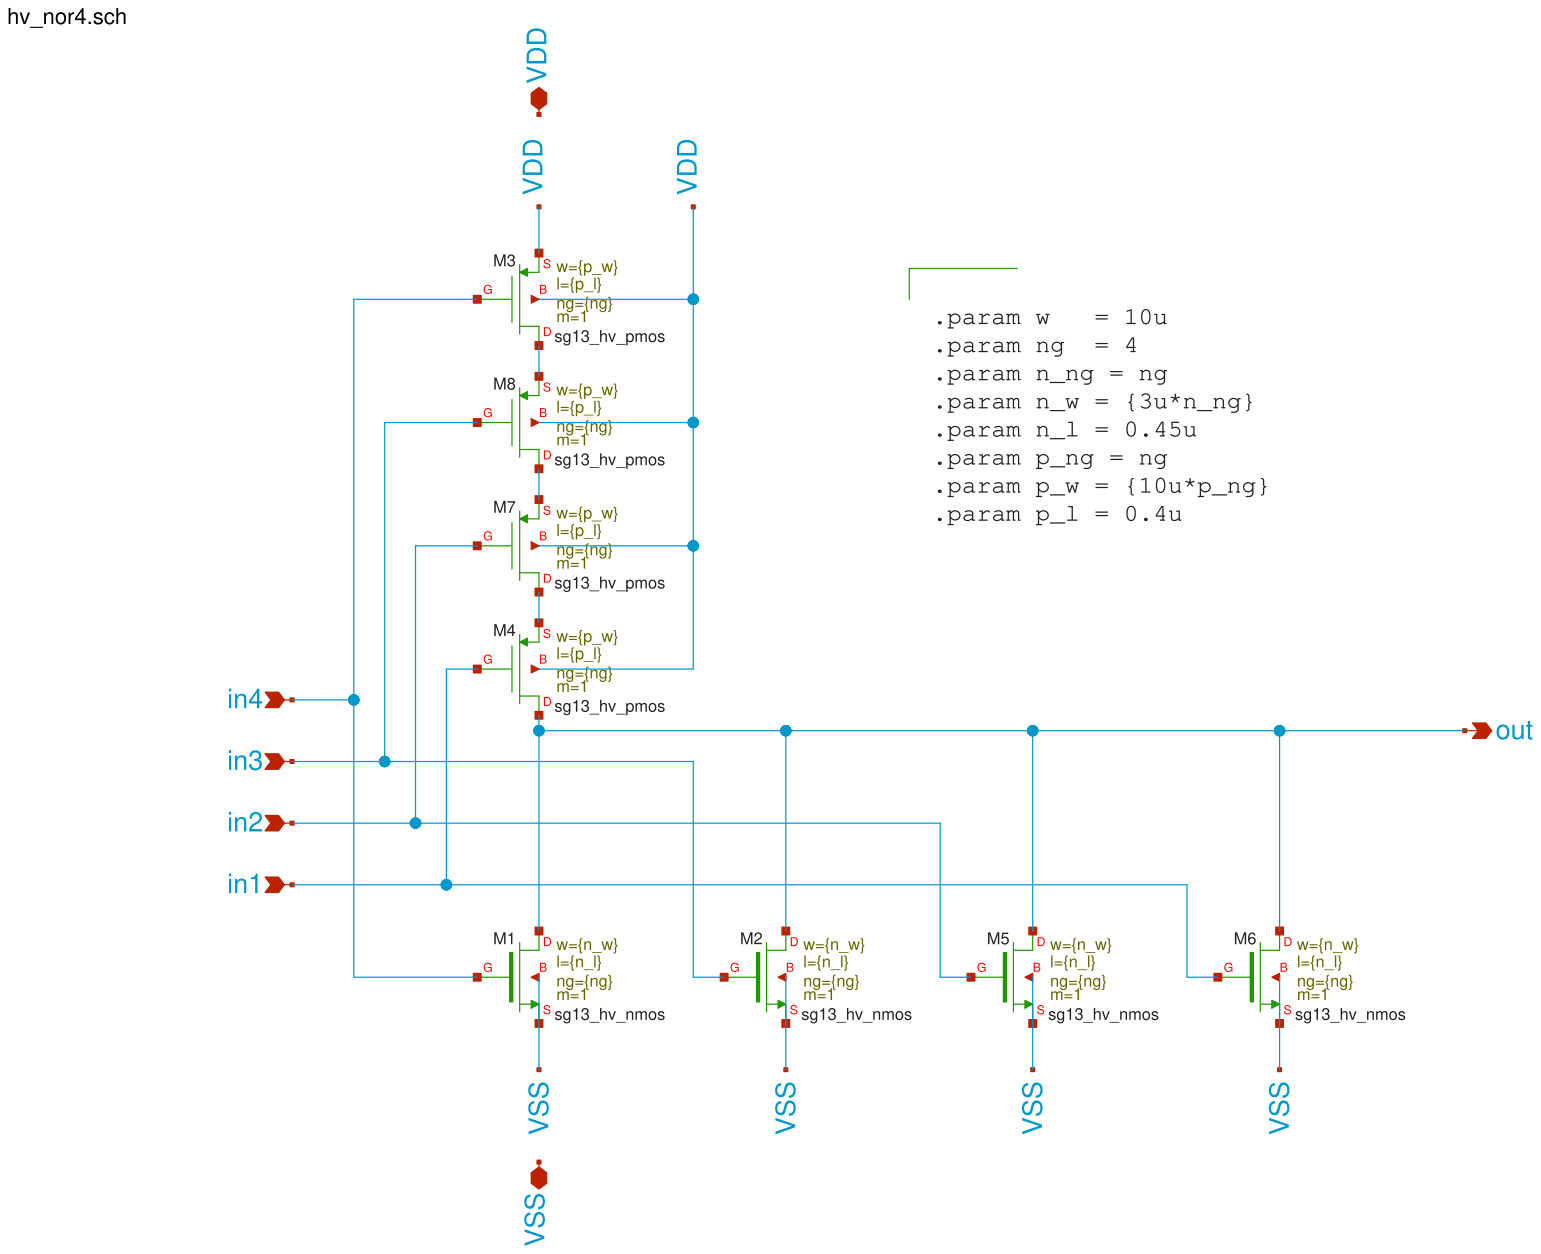
[picture p38: page 10]

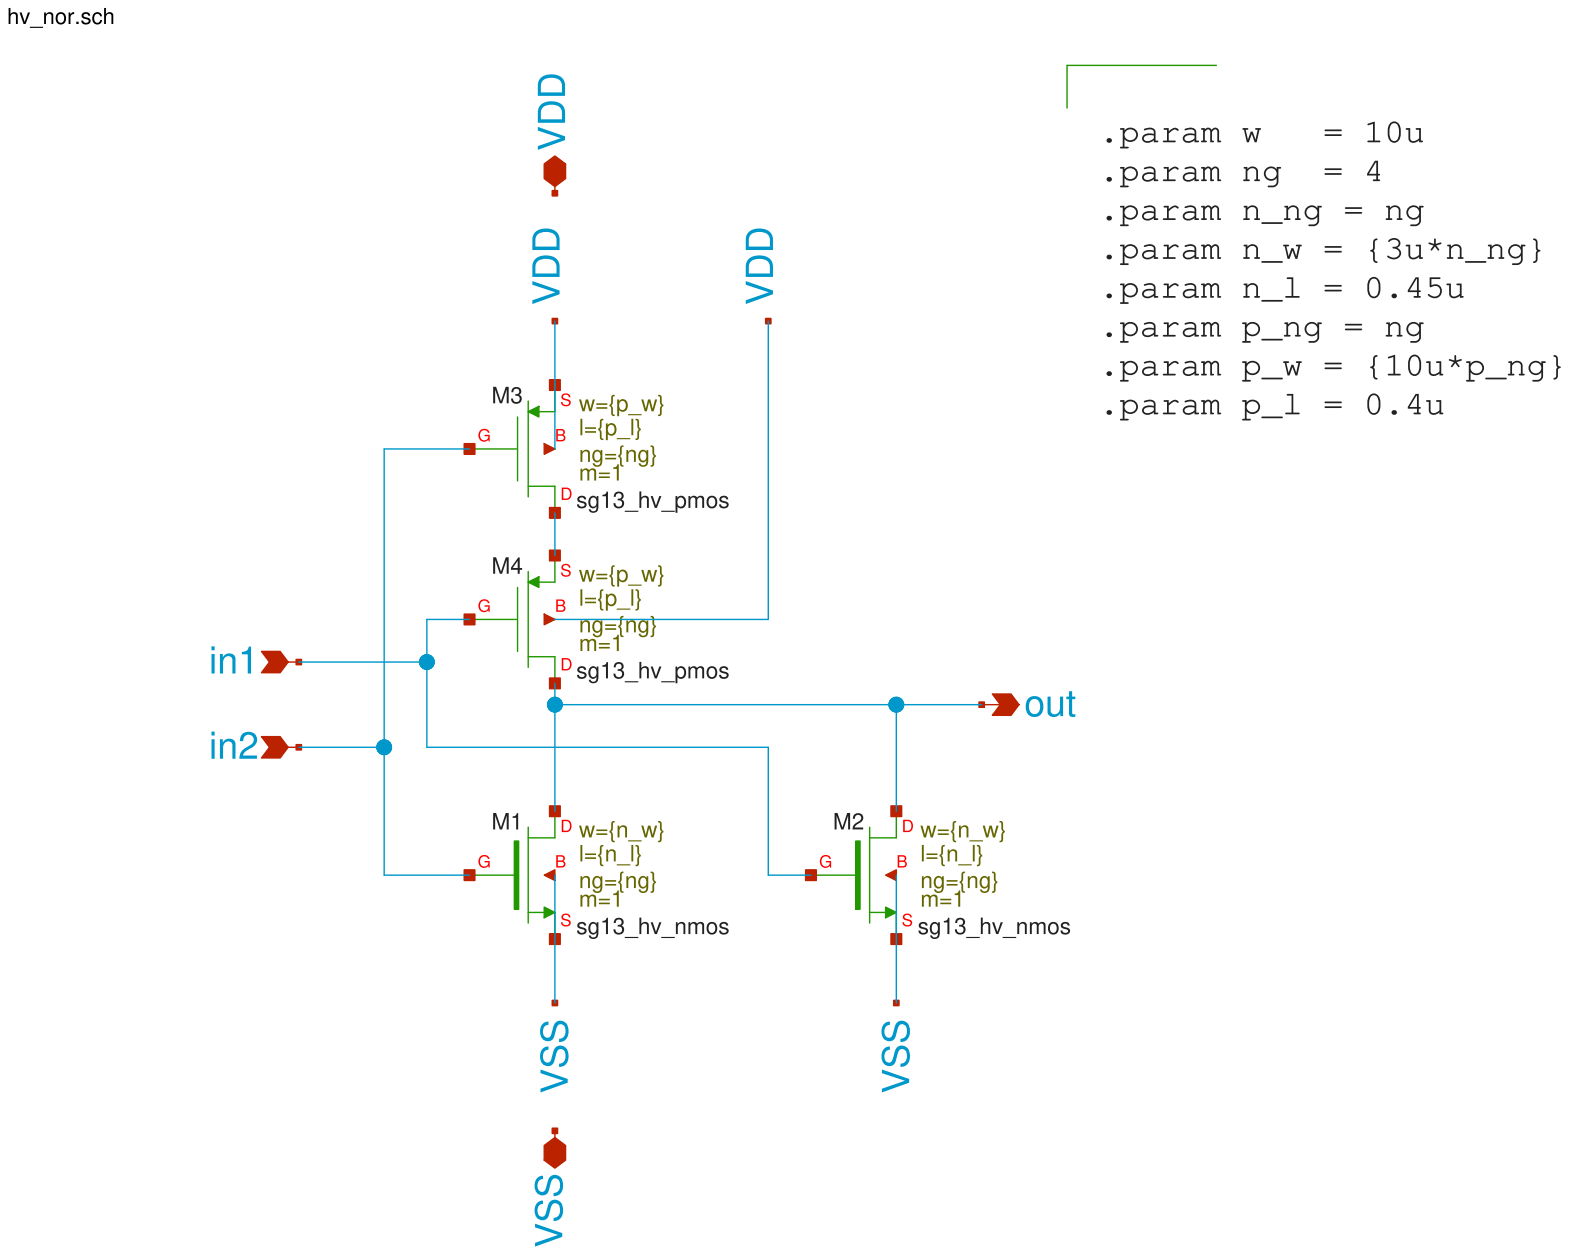
[picture p39: page 11]

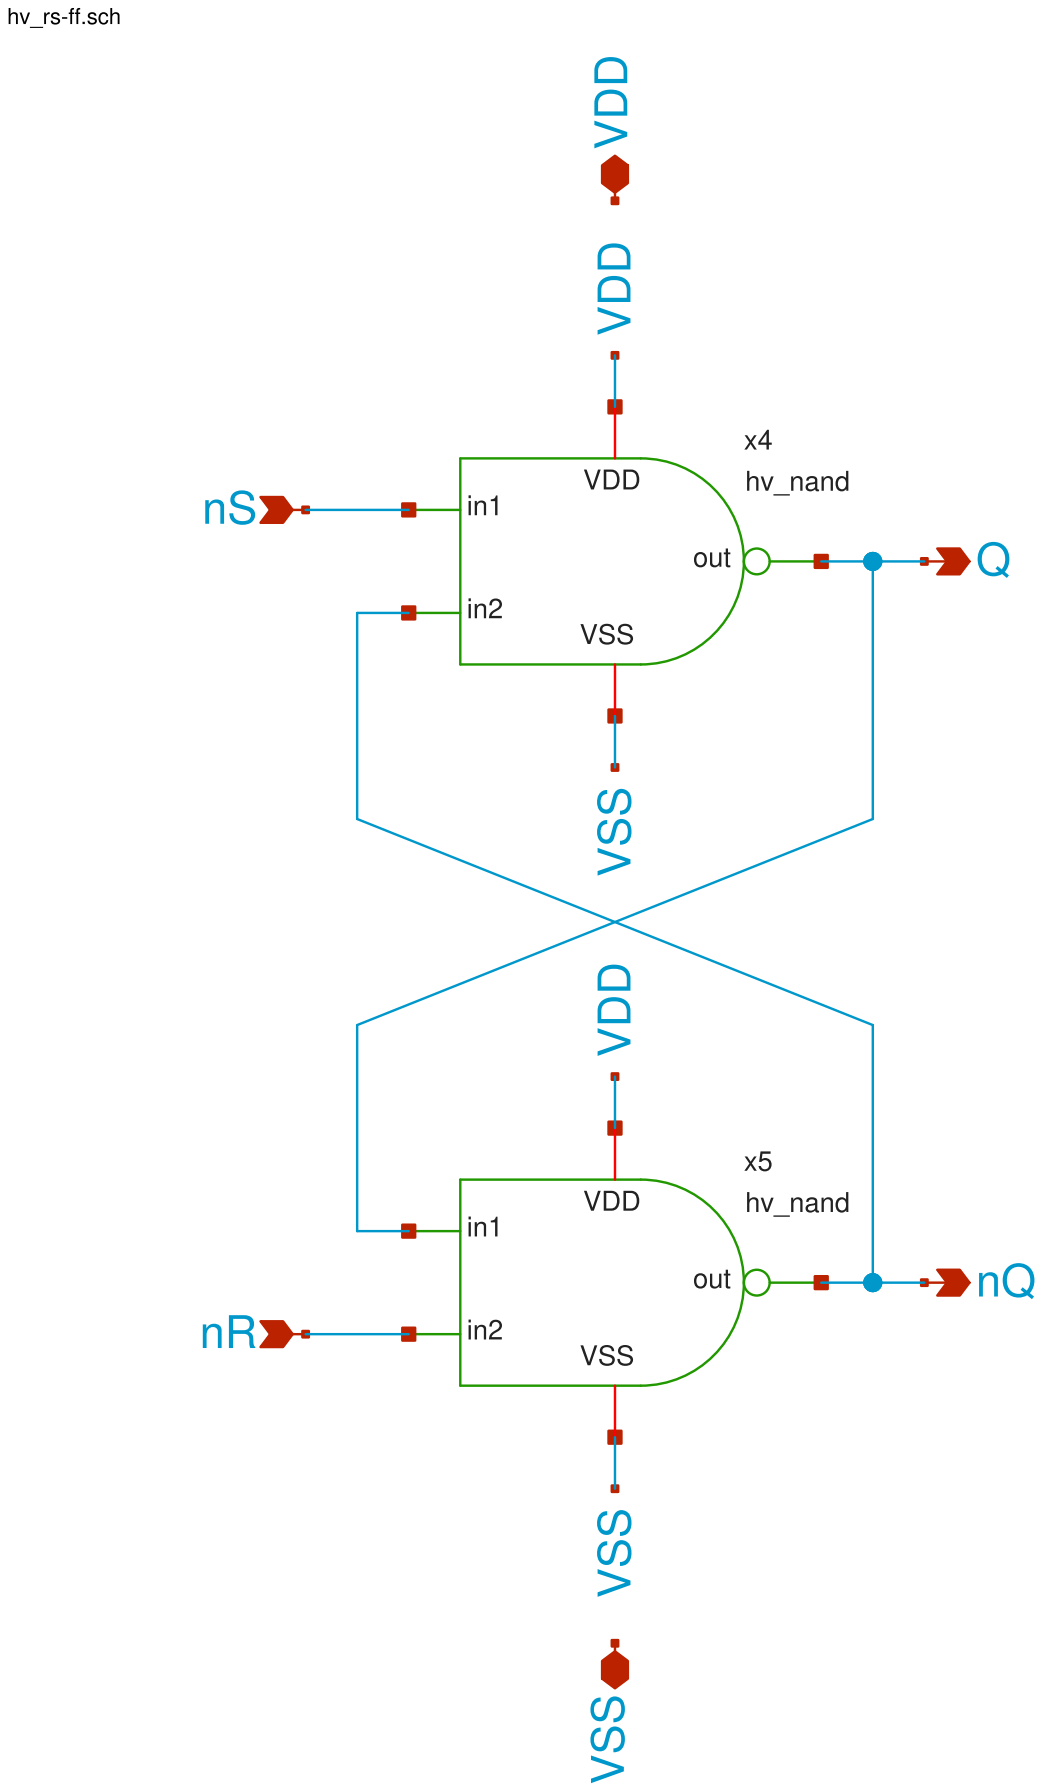
[picture p40: page 12]

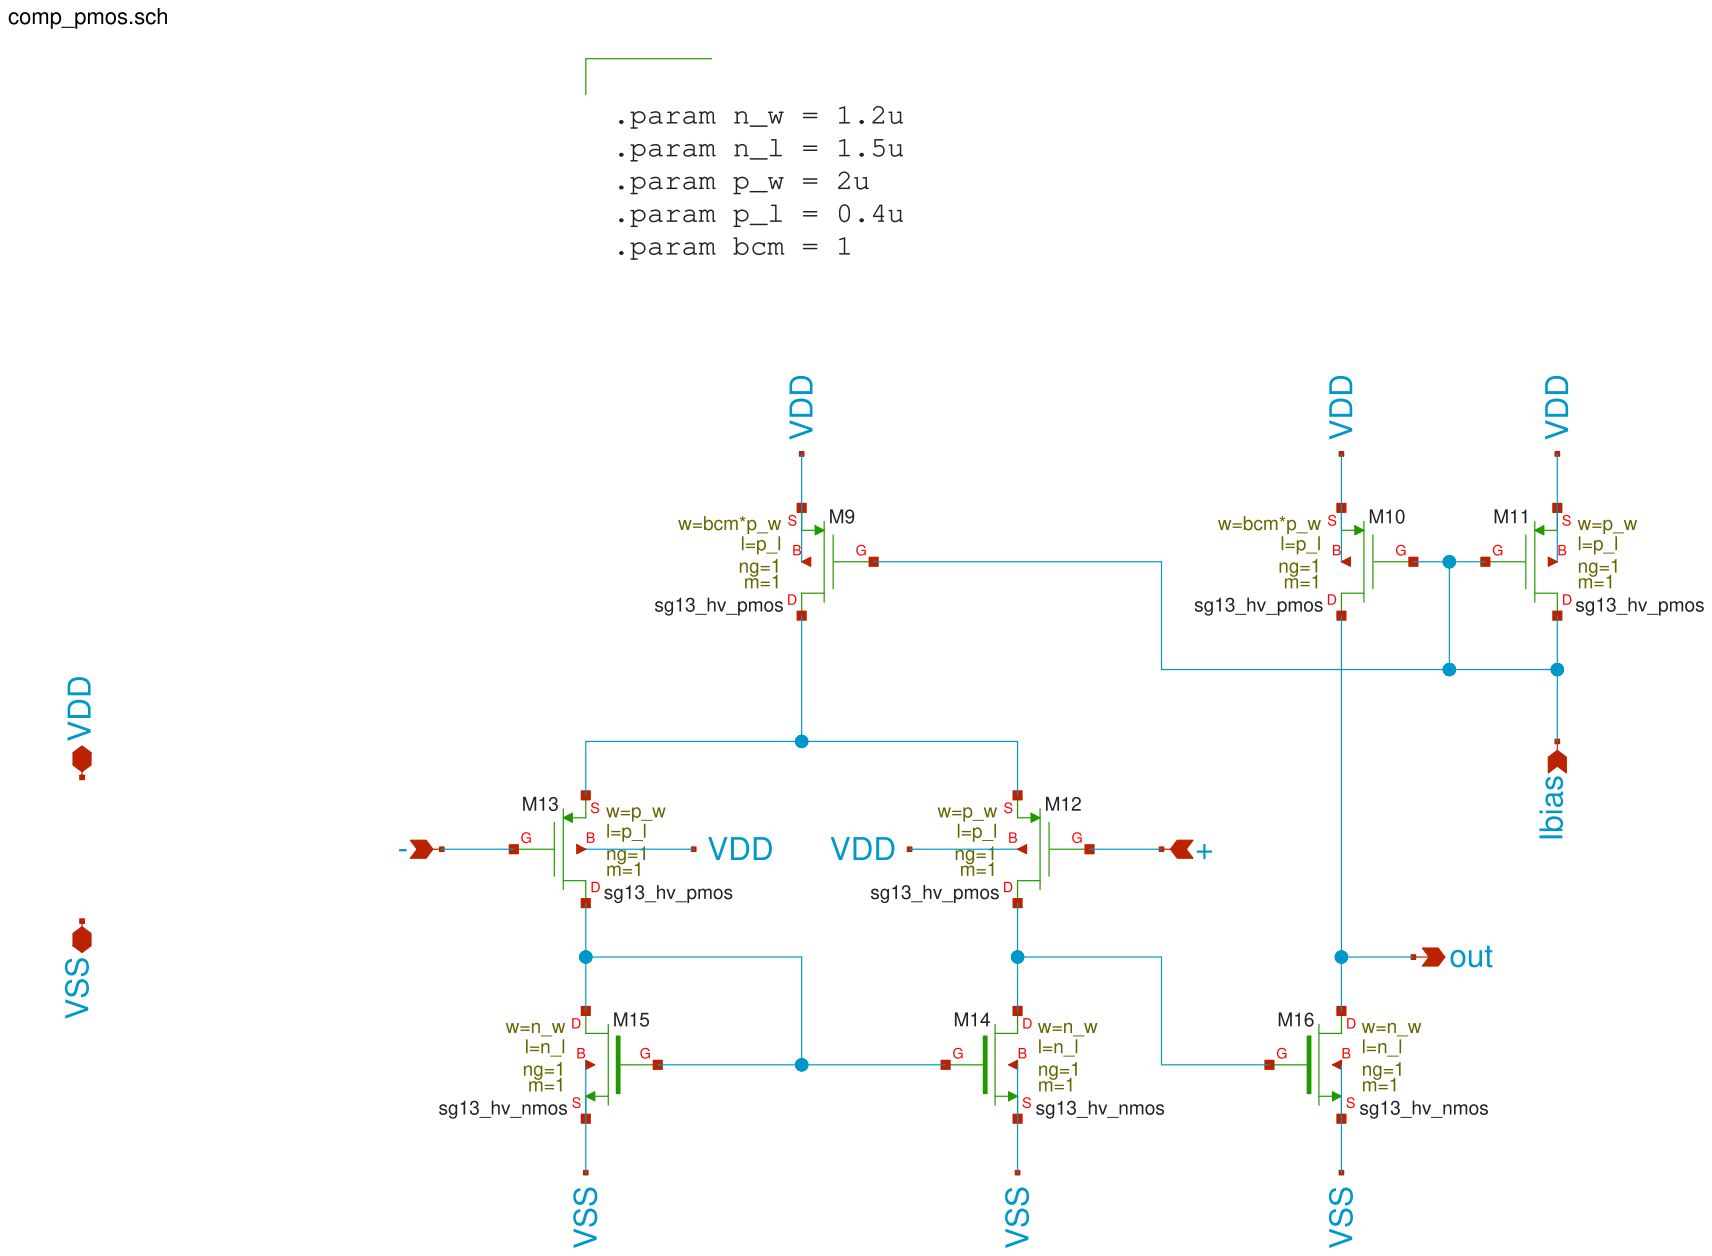
[picture p41: page 13]

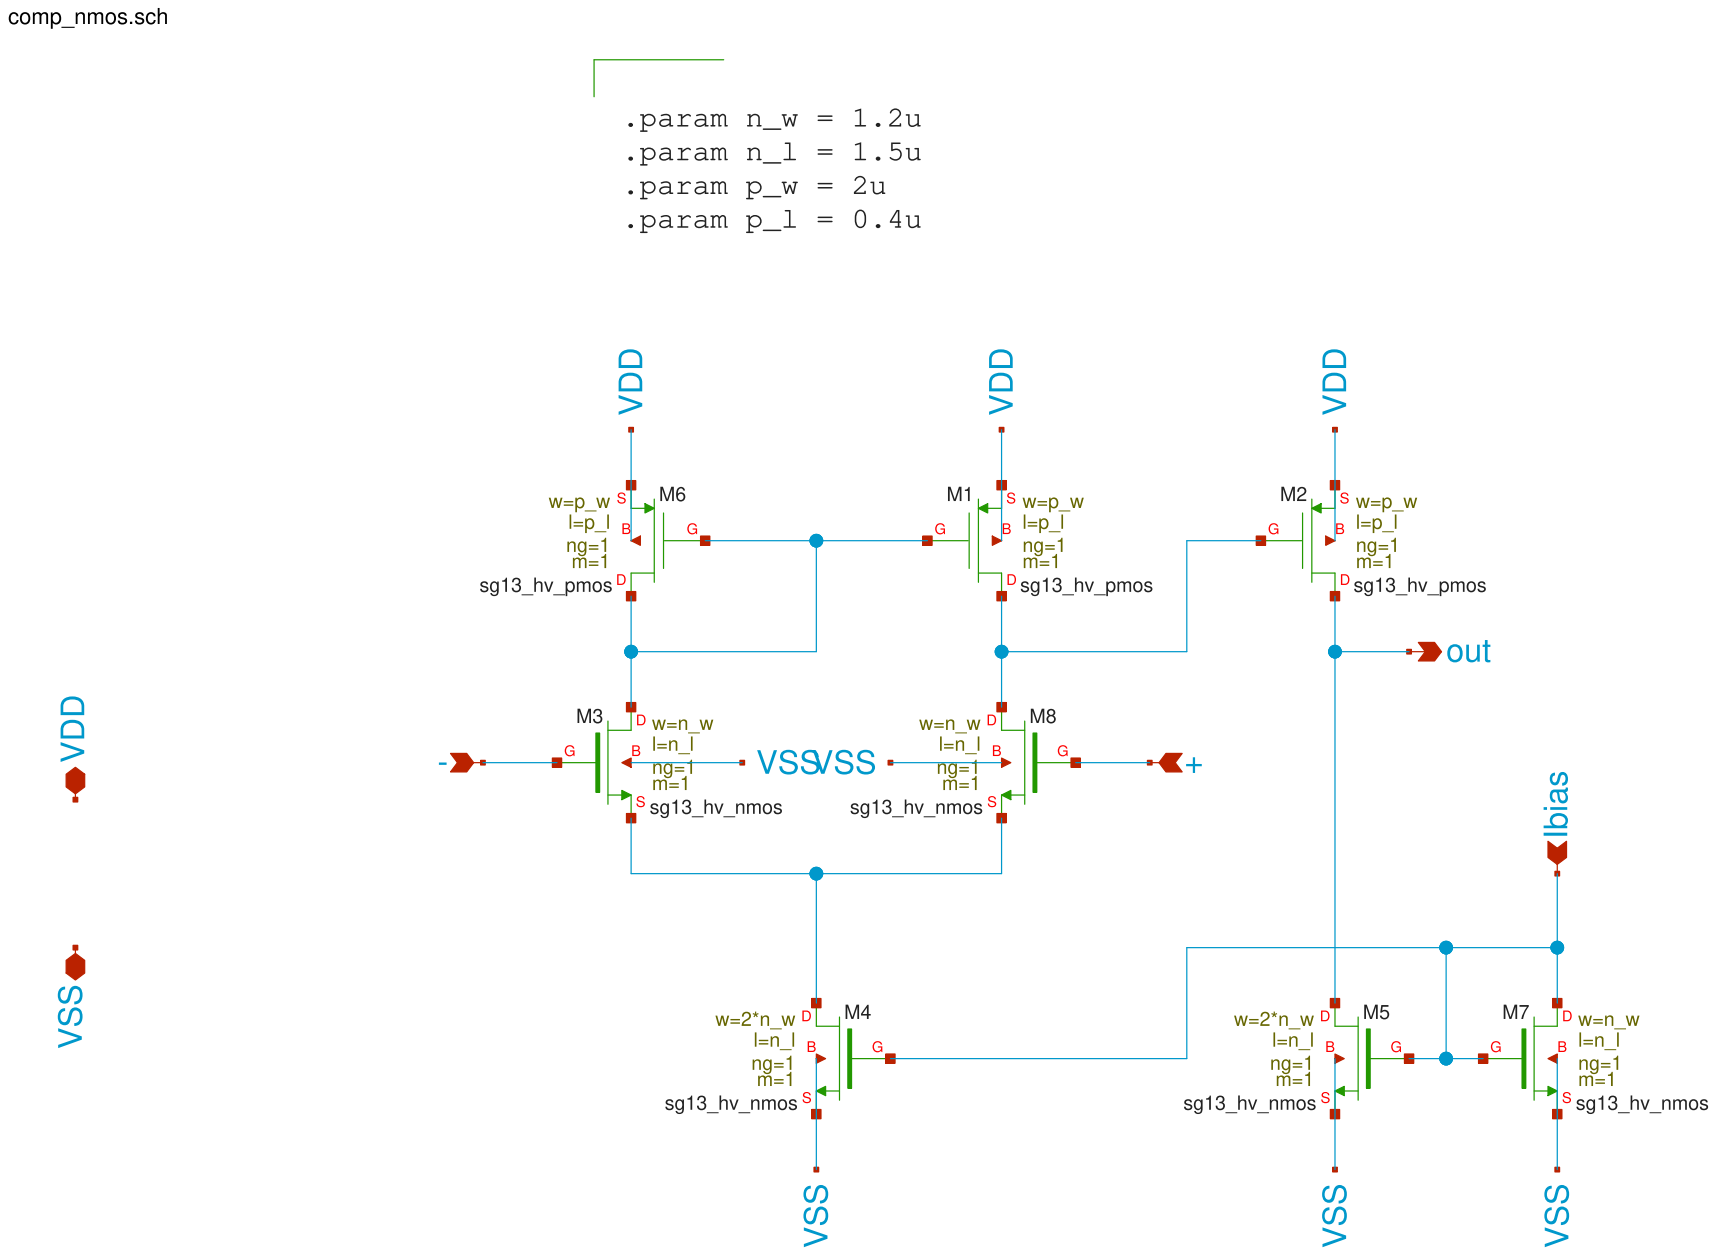
[picture p42: page 14]

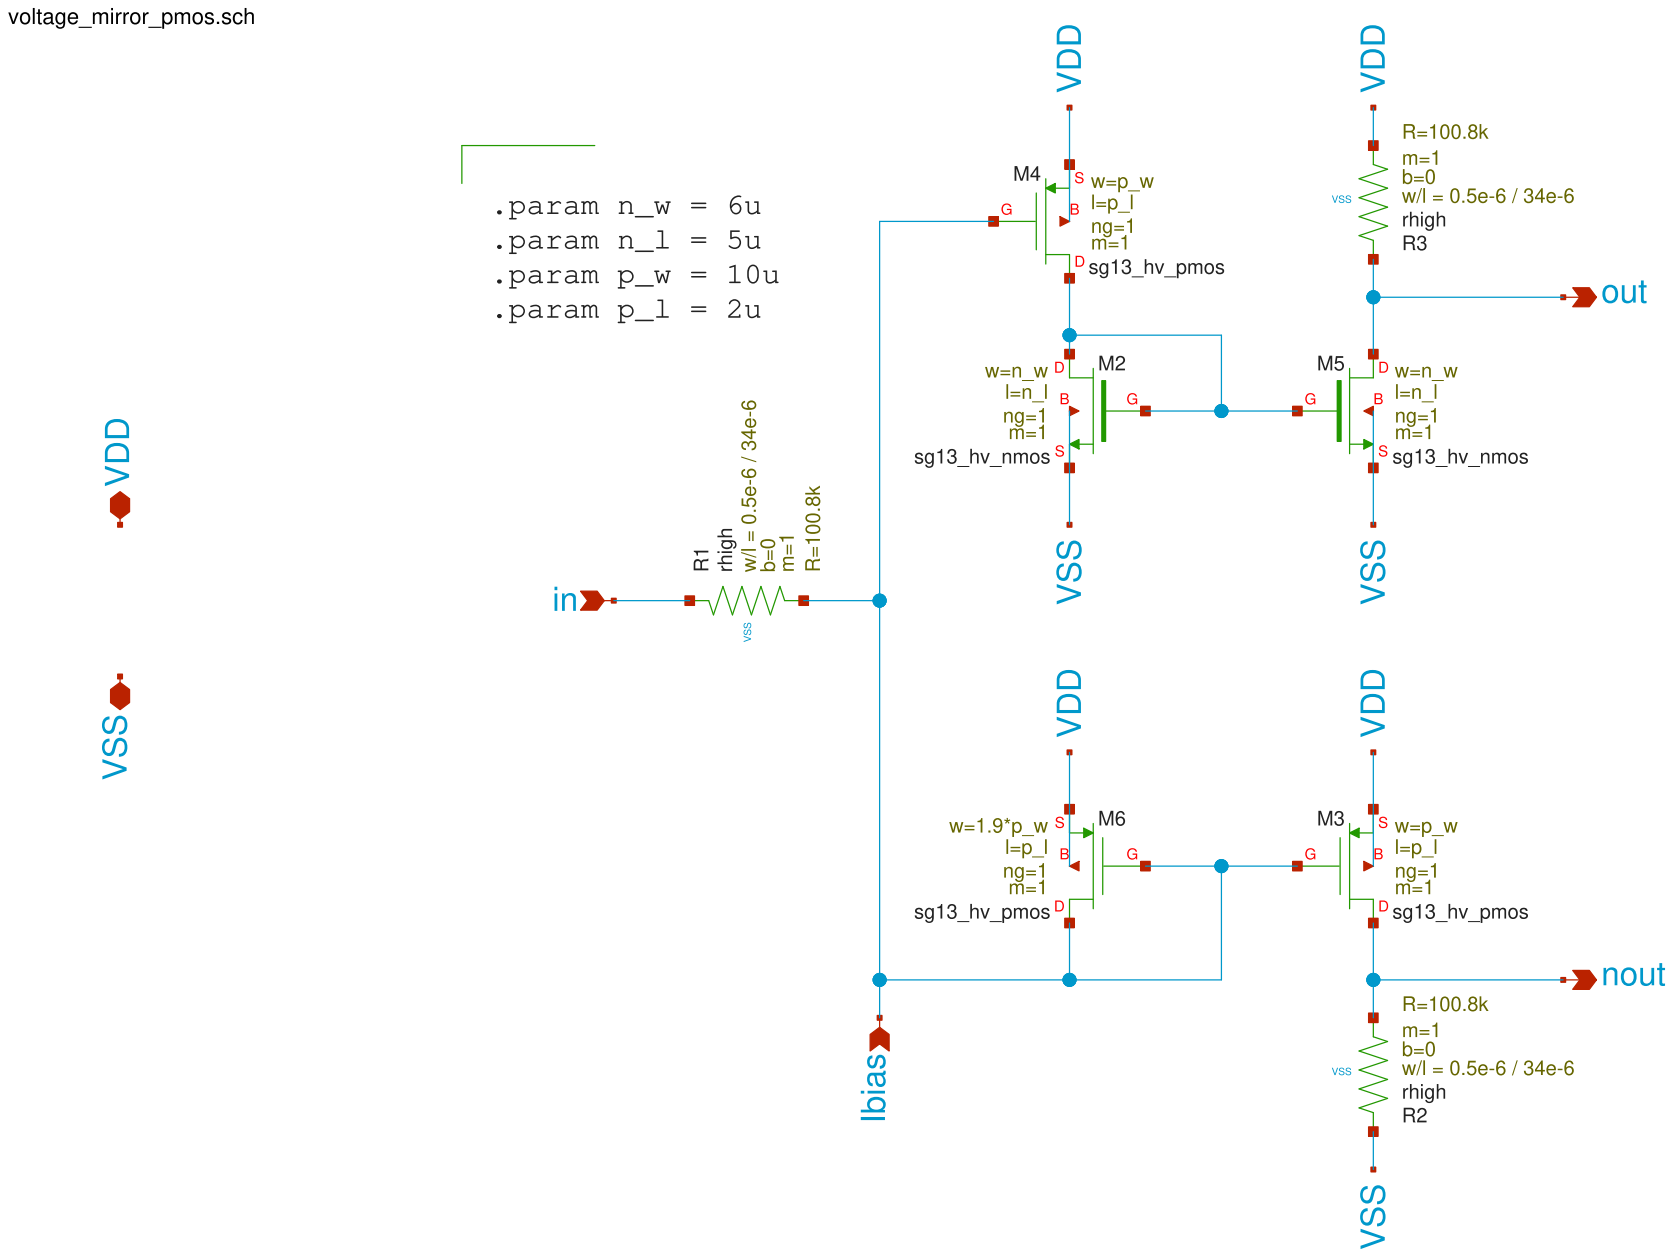
[picture p43: page 15]

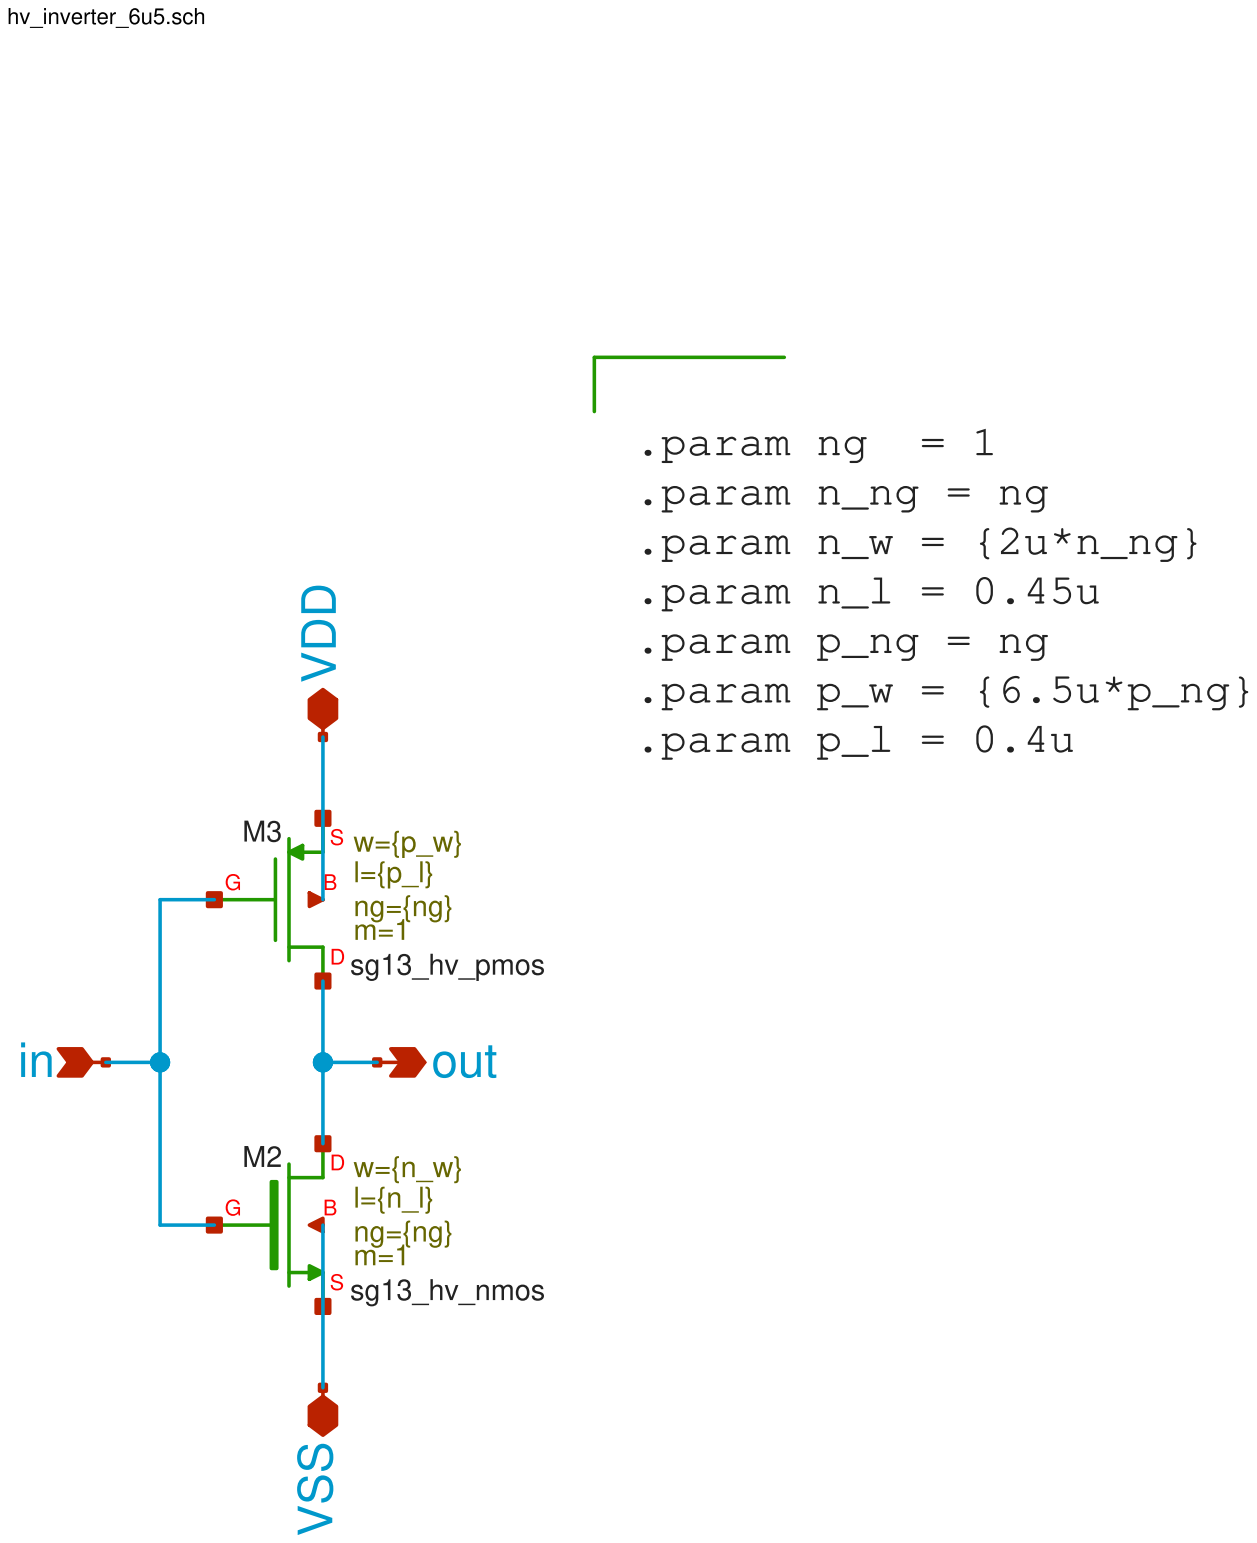
[picture p44: page 16]

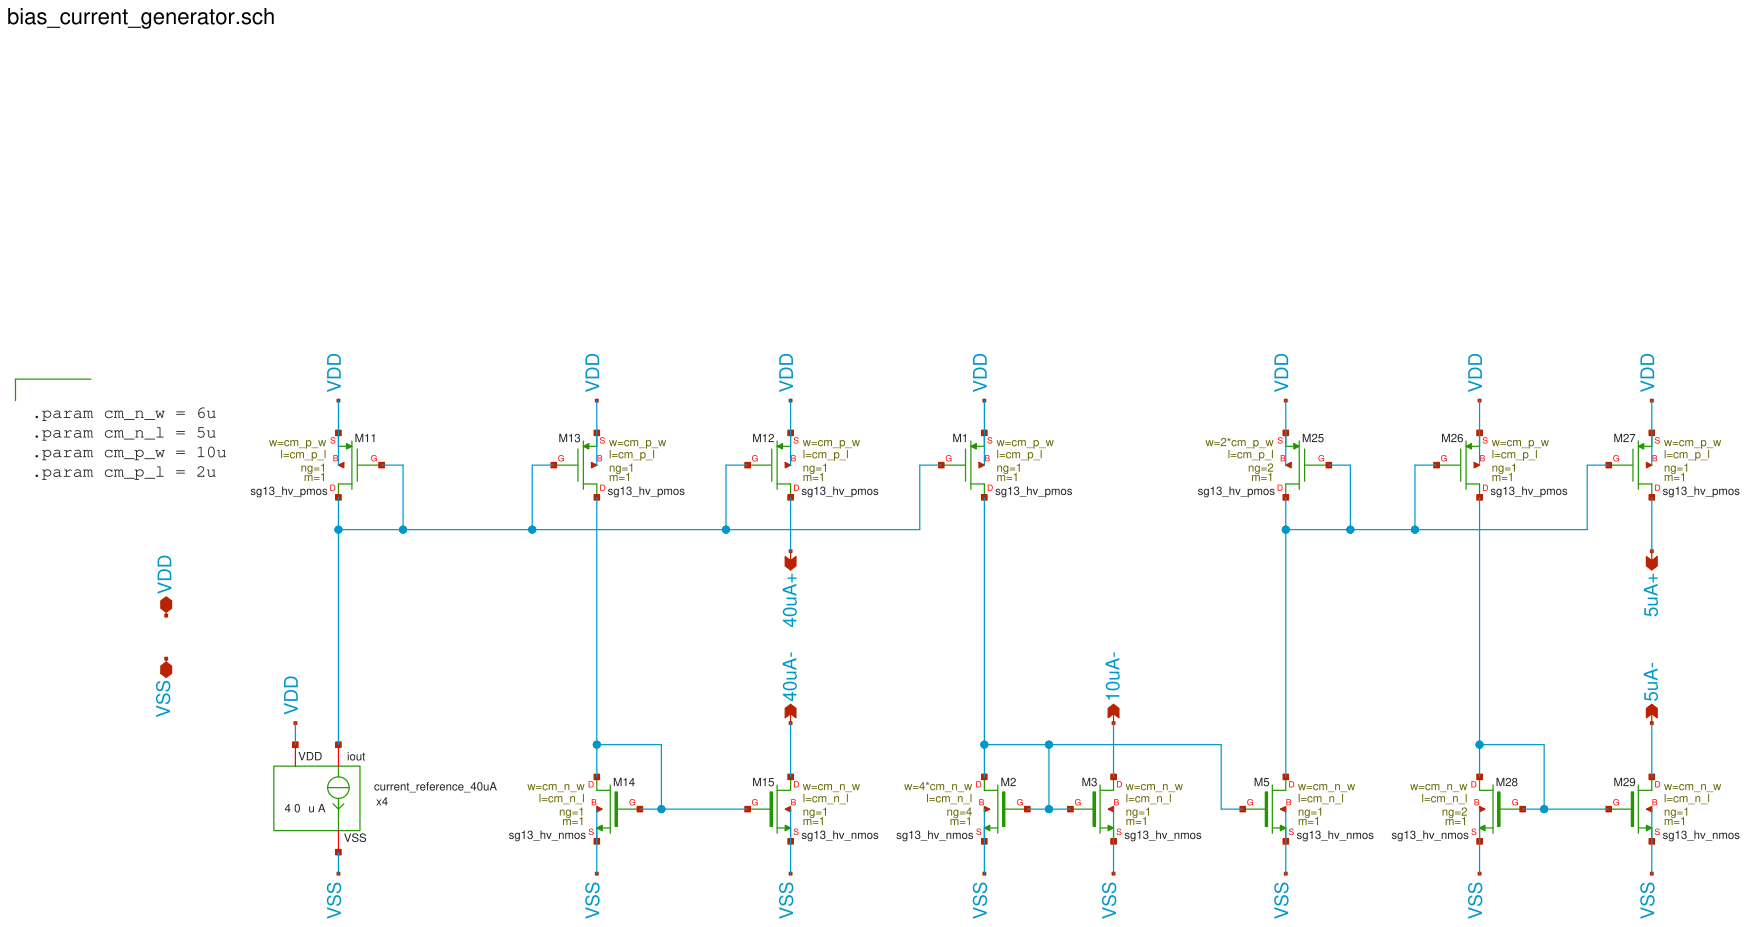
[picture p45: page 17]

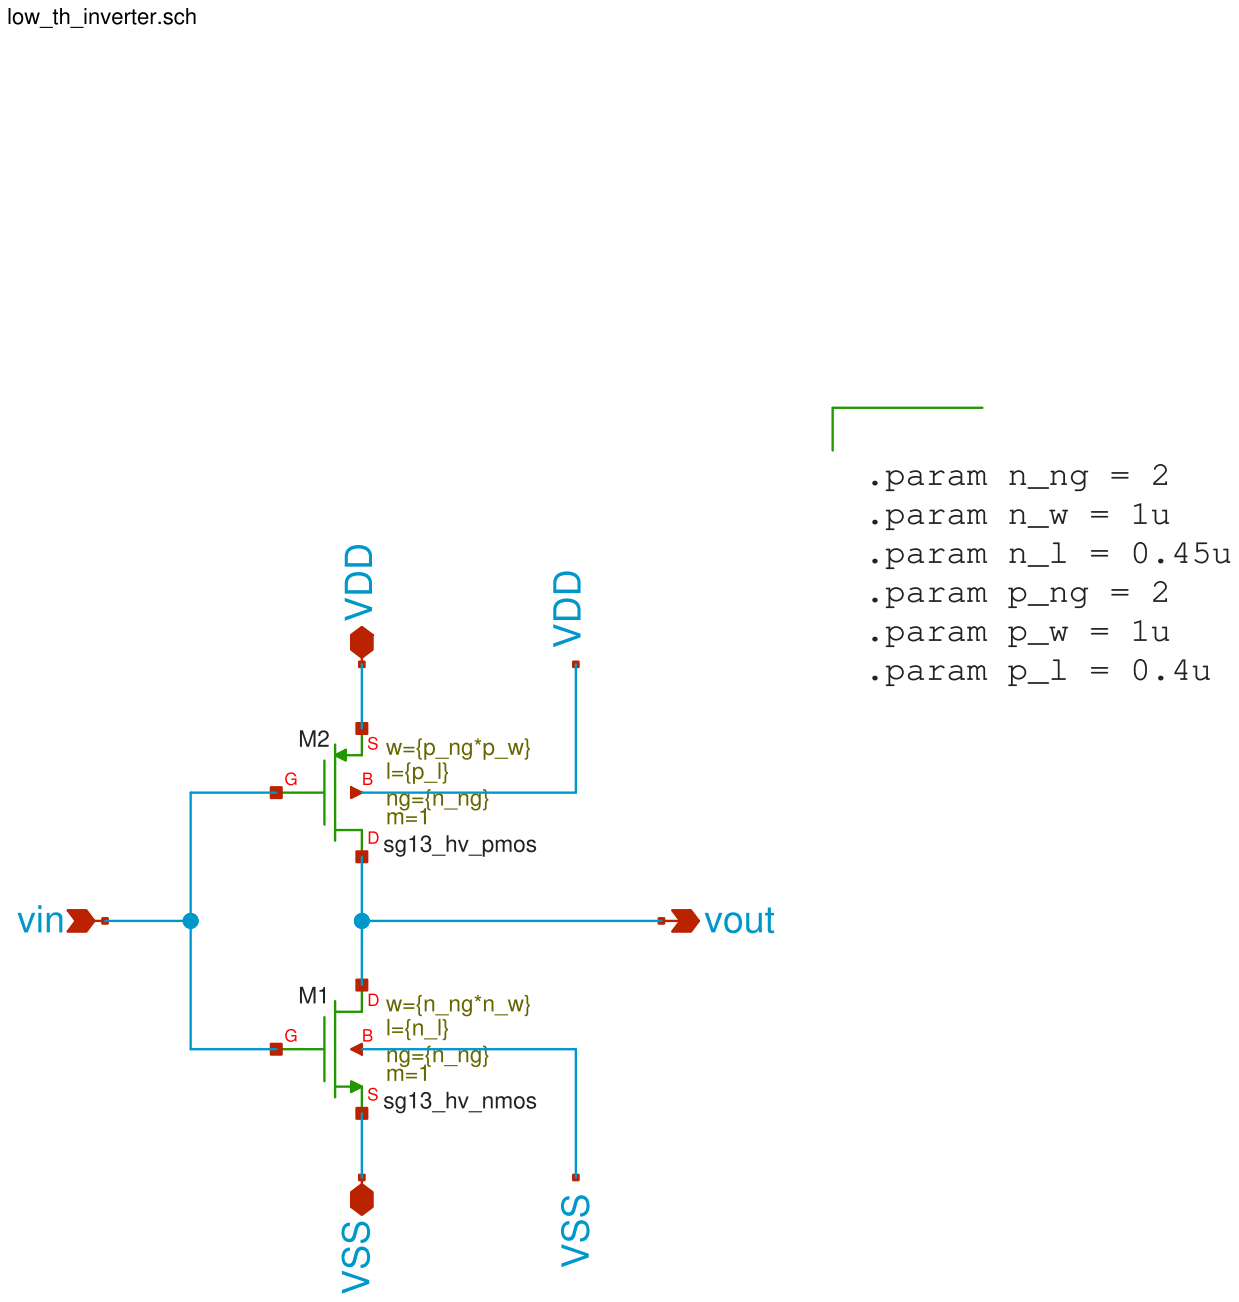
[picture p46: page 18]

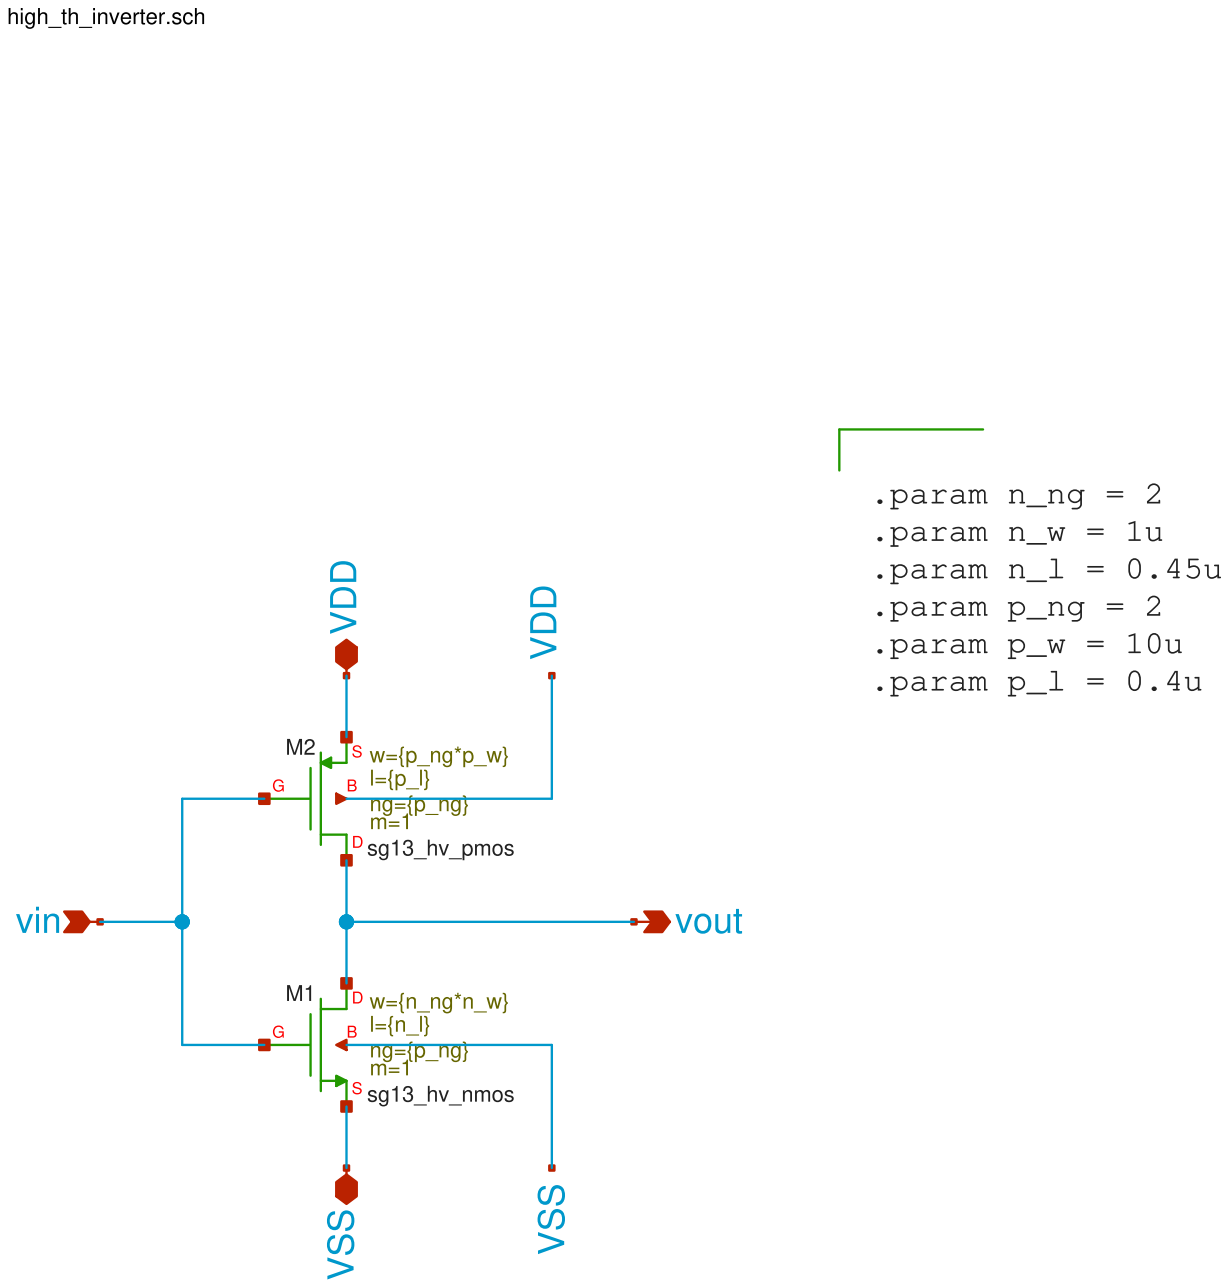
[picture p47: page 19]

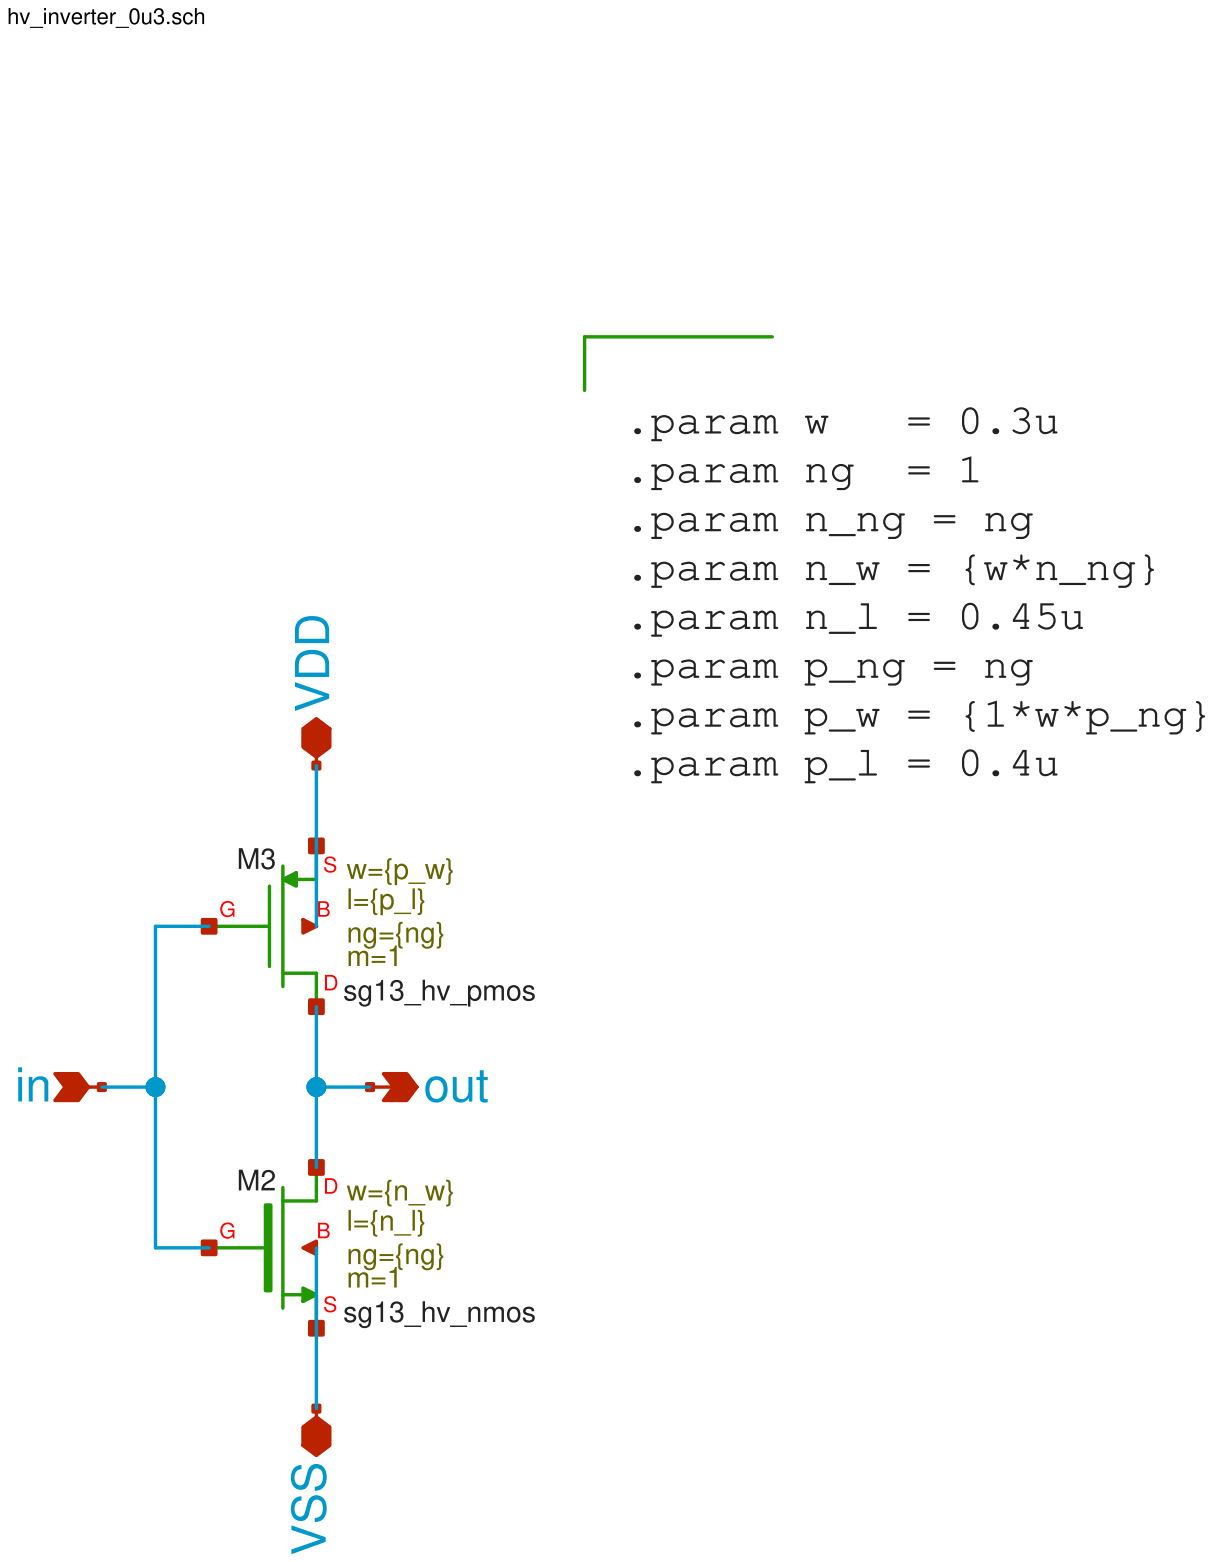
[picture p48: page 20]

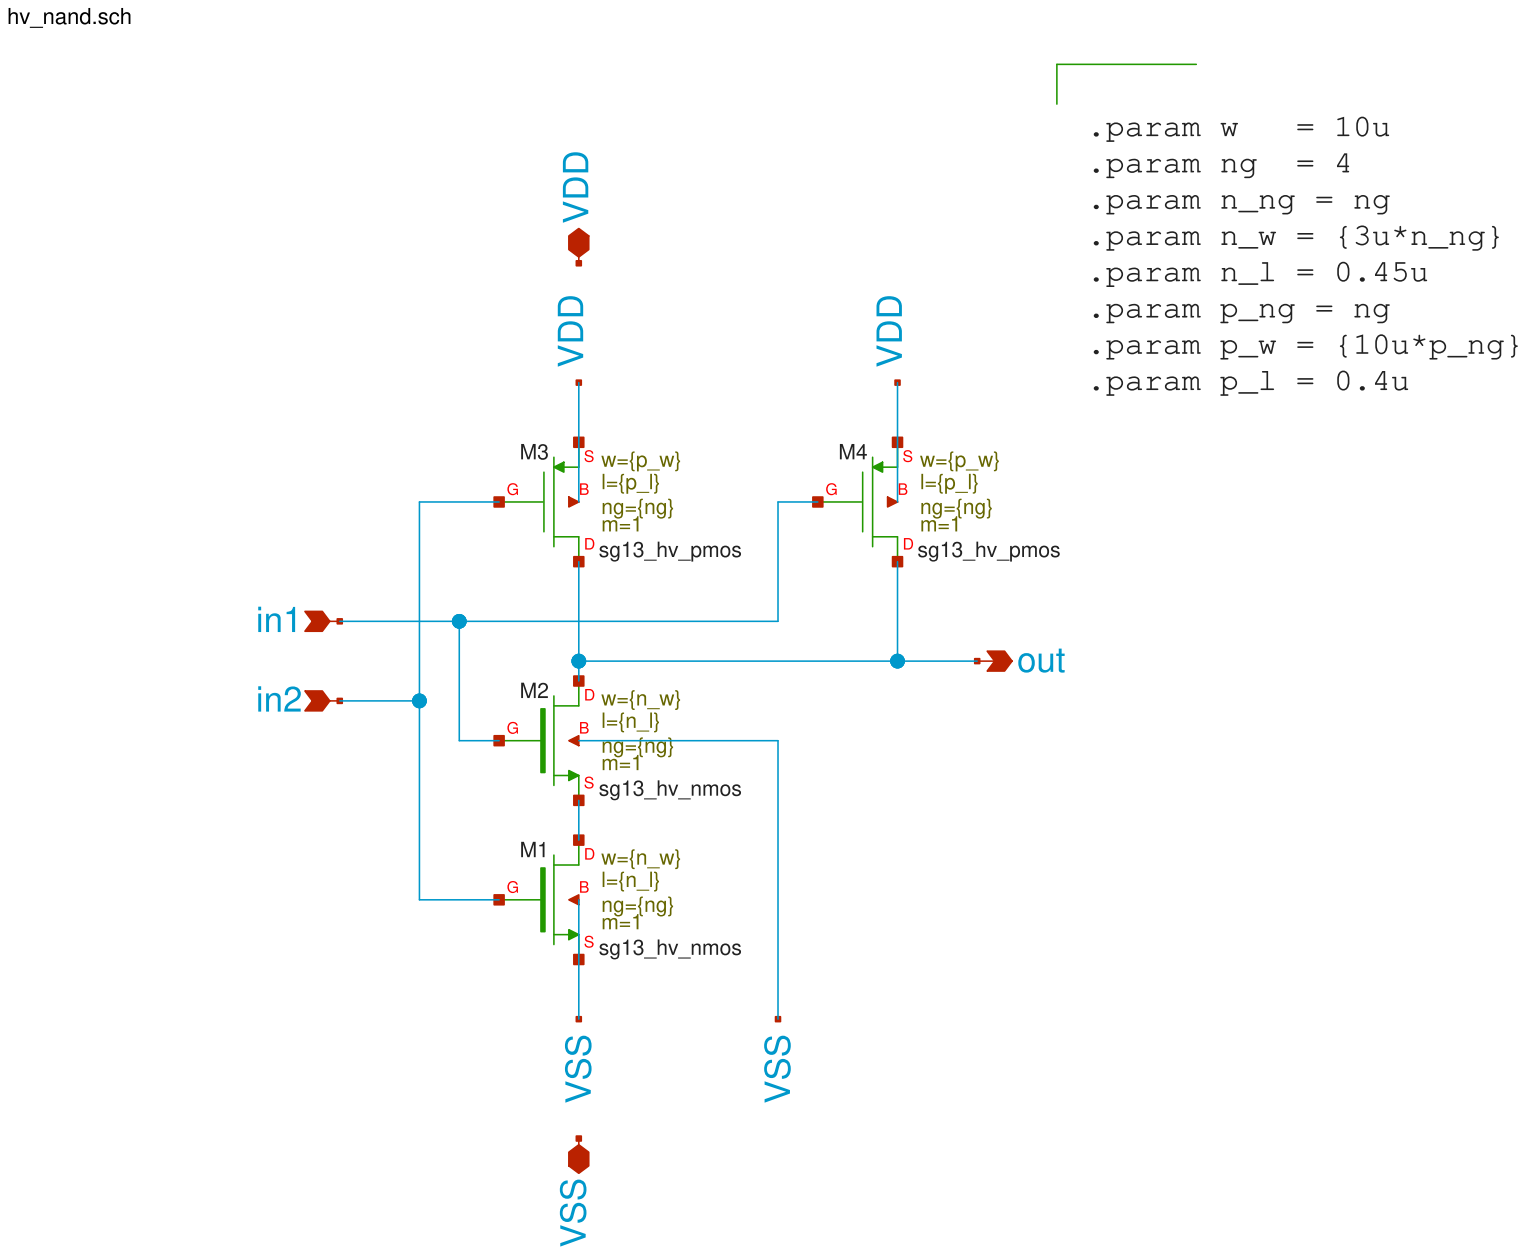
[picture p49: page 21]

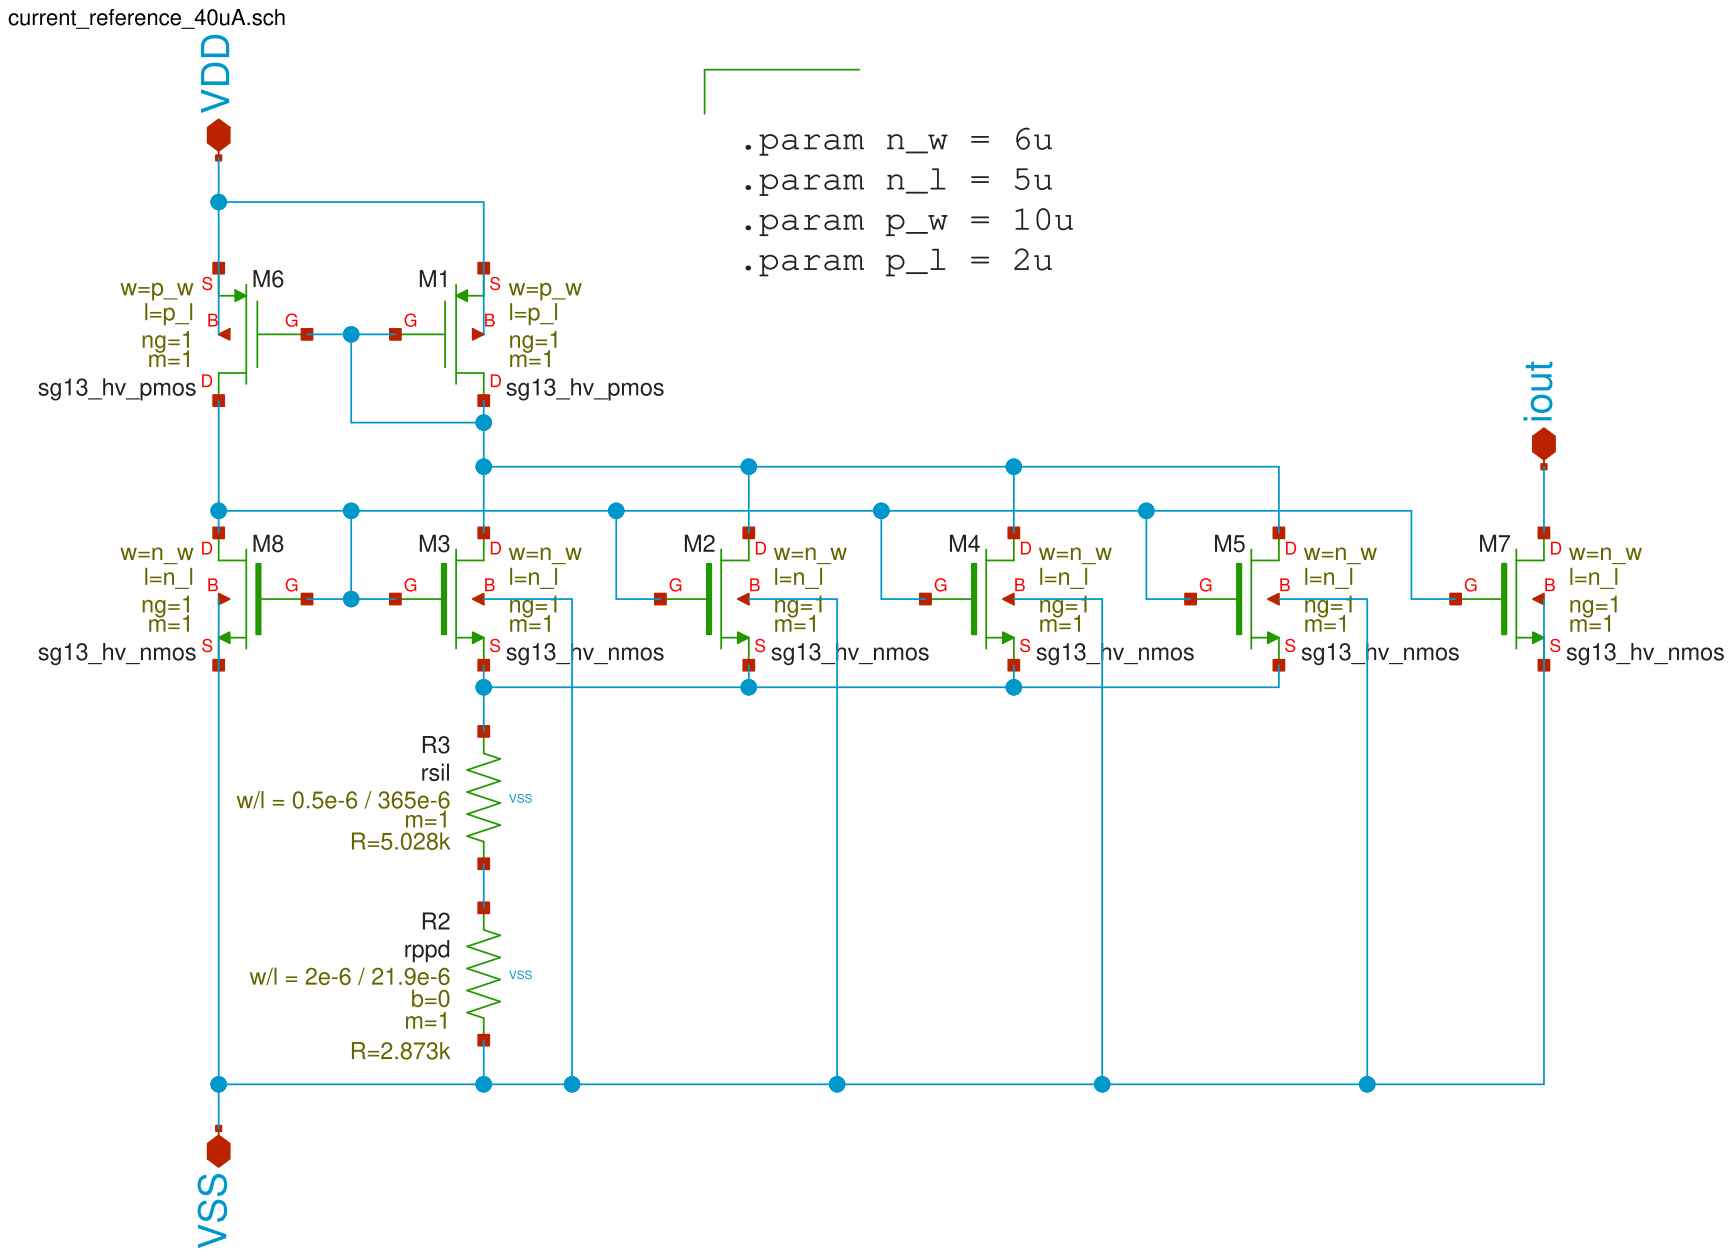
[picture p50: page 22]
