Ulf-vom-Mond/heichips26-voltage-controlled-resistor/macros/heichips26_vcr/macros/yadav/netlist/schematic/inverter_magic.spice

** sch_path: /home/noah/Documents/freizeit/heichips/heichips26-voltage-controlled-resistor/macros/heichips26_vcr/macros/yadav/schematic/xschem/inverter.sch
.subckt inverter

.ends
