Ulf-vom-Mond/heichips26-voltage-controlled-resistor/macros/heichips26_vcr/macros/switched_capacitor/netlist/schematic/current_reference_pmos_magic.spice

** sch_path: /home/noah/Documents/freizeit/heichips/heichips26-voltage-controlled-resistor/macros/heichips26_vcr/macros/switched_capacitor/schematic/xschem/current_reference_pmos.sch
.subckt current_reference_pmos

.ends
