Ulf-vom-Mond/heichips26-voltage-controlled-resistor/(commit log)

2026-08-06 first schematic
    [untitled.sch]
2026-08-06 first implementation
    [res_tb_linearity.sch, res_tb_tran.sch, untitled.sch, vcr_bisection.sch]
2026-08-06 change circuit
    [res_tb_linearity.sch, vcr_bisection.sch]
2026-08-06 switch to pmos
    [res_tb_linearity.sch, vcr_bisection.sch]
2026-08-06 switch to hv pmos
    [res_tb_linearity.sch, vcr_bisection.sch]
2026-08-06 change ng
    [vcr_bisection.sch]
2026-08-06 move vcr_bisection to macro folder
    [res_tb_linearity.sch, res_tb_tran.sch, vcr_bisection.sch]
2026-08-06 add opamp
    [inverter_tb_ac.csv, inverter_tb_ac.sch, op_amp_ver_2.sch, op_amp_ver_2_tb_tran.sch]
2026-08-06 add voltage_follower
    [inverter_tb_ac.csv, inverter_tb_ac.sch, inverter_tb_ac_ol.csv, inverter_tb_dc_vout.csv, voltage_follower.sch]
2026-08-06 move files a second time....
    [counter_tb_tran.sch, heichips26_analog_project.sch, heichips26_analog_project_tb_tran.csv, heichips26_analog_project_tb_tran.sch, inverter.sch, inverter_tb_ac.csv, inverter_tb_ac.sch, inverter_tb_ac_ol.csv]
2026-08-06 integrate voltage follower
    [res_tb_linearity.sch, vcr_bisection.sch, voltage_follower.sch]
2026-08-07 repair simulation
    [res_tb_linearity.sch, vcr_bisection.sch]
2026-08-07 add voltage_sum
    [voltage_sum.sch, voltage_sum_tb_tran.sch]
2026-08-07 Revert "add voltage_sum"
    This reverts commit 72c7d7813db7c2477f1ca4eca4530ca2e2e3988b.
    [voltage_sum.sch, voltage_sum_tb_tran.sch]
2026-08-07 Revert "add voltage_sum"
    This reverts commit 20eb97ef370c4c0b4a18083cededbb6543b3fbce.
    [voltage_sum.sch, voltage_sum_tb_tran.sch]
2026-08-07 fix voltage_sum
    [voltage_sum.sch, voltage_sum_tb_tran.sch]
2026-08-07 transmission gate and other stuff
    [cap_signal_preconditioning.sch, counter_tb_tran.sch, deadtime_generator.sch, heichips26_analog_project.sch, heichips26_analog_project_tb_tran.csv, heichips26_analog_project_tb_tran.sch, high_th_inverter.sch, hth_inv_dc_vout.sch]
2026-08-07 add differential amplifier
    [res_tb_linearity.sch, vcr_bisection.sch, voltage_diff.sch, voltage_sum.sch, voltage_sum_tb_tran.sch]
2026-08-07 update testbench
    [res_tb_linearity.sch, vcr_bisection.sch]
2026-08-07 add layout for voltage_diff
2026-08-07 i hate ngspice
    [nmos_current_mirror2.sch, osc.sch, osc_tb_tran.sch, pmos_current_mirror1.sch, pmos_current_mirror2.sch, res_tb_cm.sch, transmission_gate.sch]
2026-08-08 modify testbench - again....
    [res_tb_linearity_cm.sch, res_tb_linearity_vctrl.sch, res_tb_tran.sch]
2026-08-08 edit schematic
    add testbenches for vcm and vctrl linearity, add ideal model for vcr
    [heichips26_analog_project_tb_tran.sch, res_tb_linearity.sch, res_tb_linearity_vcm.sch, res_tb_linearity_vctrl.sch, res_tb_tran.sch, vcr_bisection_ideal_op.sch]
2026-08-08 remove identifier files
    [res_tb_linearity_vcm.sch]
2026-08-08 non-work in progress
    [nmos_current_mirror2.sch, osc.sch, osc_tb_tran.sch, res_tb_tran.sch, switched_cap_cell.sch]
2026-08-10 build a current controlled oscillator
    [nmos_current_mirror1.sch, osc.sch, osc_tb_tran.sch, pmos_current_mirror1.sch, tb_nmos_dc.sch]
2026-08-11 simplified oscillator circuit and improved simulation by adding .ic directive
    [osc.sch, osc_tb_tran.sch]
2026-08-11 added voltage to current converter testbench
    [tb_v-to-i_dc.sch]
2026-08-27 switch to rtr opamp
    [opamp_rtr.sch, res_tb_linearity_vcm.sch, res_tb_tran.sch, vcr_bisection.sch, voltage_diff.sch]
2026-08-27 fix polarity of opamp
    [res_tb_linearity.sch, res_tb_linearity_vcm.sch, res_tb_tran.sch, vcr_bisection.sch, voltage_diff.sch]
2026-08-27 change dimension of mosfet
    [res_tb_linearity.sch, res_tb_linearity_vcm.sch, vcr_bisection.sch]
2026-08-27 add testbench for fixed terminal
    [res_tb_linearity_fix.sch, vcr_bisection.sch, voltage_sum.sch]
2026-08-27 optimize mosfet dimensions
    [res_tb_linearity_fix.sch, res_tb_tran.sch, vcr_bisection.sch]
2026-08-27 first working version of the switched-capacitor approach
    [current_reference_40uA.sch, current_reference_pmos_40uA.sch, high_th_inverter.sch, hth_inv_dc_vout.sch, hv_inverter_40u.sch, low_th_inverter.sch, lth_inv_dc_vout.sch, osc.sch]
2026-08-28 improved simulation of switched cap cell
    [tb_switched_cap_tran_sweep.sch]
2026-09-06 built another vco, some hv logic gates and a voltage mirror
    [comp_nmos.sch, comp_pmos.sch, hv_and.sch, hv_mux.sch, hv_mux4.sch, hv_nand.sch, hv_nor.sch, hv_nor4.sch]
2026-09-07 build voltage max circuit
    [res_tb_linearity_fix.sch, untitled.sch, vcr_bisection.sch, voltage_max.sch]
2026-09-07 simulated the circuit with the new oscillator
    [switched_cap_cell.sch, tb_switched_cap_tran.sch, tb_switched_cap_tran_sweep.sch, tb_vco_tran.sch, tb_voltage_mirror_pmos_dc.sch, voltage_mirror.sch, voltage_mirror_pmos.sch]
2026-09-07 wire bulk to vdd, implement tb for voltage_max
    [vcr_bisection.sch, vmax_tb.sch, vmax_tb_fix.sch, vmax_tb_tran.sch, voltage_max.sch]
2026-09-07 switch to nmos
    [res_tb_linearity.sch, res_tb_linearity_fix.sch, res_tb_linearity_vcm.sch, vcr_bisection.sch]
2026-09-08 change to single transistor
    [res_tb_linearity.sch, vcr_bisection.sch]
2026-09-14 add new opamp_rtr as submodule
    [vcr_bisection.sch, voltage_sum.sch]
2026-09-14 clean up unused files
    [inverter.sch, inverter_tb_ac.csv, inverter_tb_ac.sch, inverter_tb_ac_ol.csv, inverter_tb_ac_ol.sch, inverter_tb_dc_vout.csv, inverter_tb_dc_vout.sch, inverter_tb_tran.sch]
2026-09-14 Create heichips26_vcr
    [heichips26_analog_project.sch]
2026-09-14 yadav: merge into main
    [YadavVCR.sch, inverter_tb_ac.csv, inverter_tb_ac.sch]
2026-09-15 layout for vco, pulse_shaper and transmission_gate done
    [bias_current_generator.sch, current_reference_40uA.sch, hth_inv_pex_dc_vout.sch, hv_inverter_0u3.sch, hv_inverter_6u5.sch, hv_nor.sch, hv_nor4.sch, inverter_tb_ac_ol.sch]
2026-09-17 add isource_beta
    [vcr_bisection.sch]
2026-09-17 change to rppd resistors for better matching
    [res_tb_tran.sch, vcr_bisection.sch, voltage_sum.sch]
2026-09-17 wire resistor network
2026-09-17 finish wiring
2026-09-17 alpha version of switched cap cell implementation and layout, no verification done
    [hv_binary_decoder4.sch, hv_mux4.sch, lvl_shift_down.sch, lvl_shift_up.sch, osc.sch, osc_pex_tb_tran.sch, pulse_shaper_en.sch, switched_cap_cell.sch]
2026-09-17 rebuild symbol
    [vcr_bisection.sch]
2026-09-18 fixed some LVS errors, manually added capacitors to PEX netlist, built PEX simulation
    [osc_pex_tb_tran.sch, switched_cap_cell.sch, tb_switched_cap_pex_tran.sch]
2026-09-18 wire vdd and vss
2026-09-18 wire bias currents
2026-09-18 PEX simulation produces promising results
    [tb_switched_cap_pex_tran.sch]
2026-09-18 lvs clean
    [vcr_bisection.sch]
2026-09-18 move vcr_bisection
    [heichips26_analog_project.sch, heichips26_analog_project_tb_tran.csv, res_tb_linearity.sch, res_tb_linearity_fix.sch, res_tb_linearity_vcm.sch, res_tb_linearity_vctrl.sch, res_tb_tran.sch, vcr_bisection.sch]
2026-09-18 switch vcr_bisection to relative paths
    [vcr_bisection.sch, voltage_sum.sch]
2026-09-18 removed power supply lines from metal4 layer
2026-09-18 fixed short circuit in switched_cap_cell layout
2026-09-18 added a schematic version without cmomi components for use with LVS
    [osc_wcap.sch, switched_cap_cell_wcap.sch, tb_switched_cap_pex_tran.sch, tb_switched_cap_tran.sch, tb_switched_cap_tran_sweep.sch, vco_wcap.sch]
2026-09-24 drew top level schematic
    [analog_switch_3pst.sch, heichips26_analog_project.sch, pulse_shaper_en.sch, switched_cap_cell.sch]
2026-09-25 wip: adding another transmission gate to the control input of the switched cap cell
2026-09-25 added transmission gate to vctrl input of switched cap cell: drc and lvs clean
2026-09-25 modified heichips26_vcr/schematic/xschem/xschemrc to automatically include all symbols from sub-macros of the heichips-vcr macro. this is needed to make lvs work in the heichips26_vcr macro
2026-09-25 layout for analog_switch_3pst done
    [lvl_shift_up.sch]
2026-09-25 intermediate commit
    [switched_cap_cell.sch, switched_cap_cell_wcap.sch]
2026-10-12 added some explanation for the switched capacitor circuit to the readme
2026-10-12 added xschem pdf plots for switched capacitor schematics
2026-10-12 add link to switched capacitor plots in README.md
